openedv/development_board_ATK-DLT527B/01_codes/README.md

## Codes

You can find the codes by clicking on [here](https://mega.nz/folder/zkAyCAJb#j_hG5ZL9e9u3v6Ev81a87w).
