openedv/development_board_ATK-DLT527B/03_core_board/01_core_board_pin_definitions/T527_PINOUT_V1.00.xlsx

Sheet: Revision History
Revision History
Revision | Date | Author | Description
0.90 | 2023-11-16 | AWA1896 | Initial Release Version
0.91 | 2024-07-24 | AWA1896 | 1. Modify "PWM3" to "PWM0-3" in Sheet "2 GPIO multiplex function". 2. Update the description of PCIE0-PERSTN signal and S-TW2 signal in Sheet ""3 Signal Description".
0.92 | December 16,2024 | AWA1233 | Update the description of GMAC in Sheet "3 Signal Description".
1.00 | 2026-01-12 | AWA1233 | Release Version

Sheet: 1 Pin Characteristics
Ball#[1] | Pin Name[2] | Type[3] | Ball Reset State[4] | Pull Up/Down[5] | Default Buffer Strength[6] | I/O Power Supply[7]
SDRAM
AK33 | SA0 | O | N/A | N/A | N/A | VCC-DRAM/VCC-DRAML
AG30 | SA1 | O | N/A | N/A | N/A | VCC-DRAM/VCC-DRAML
AJ33 | SA2 | O | N/A | N/A | N/A | VCC-DRAM/VCC-DRAML
AL27 | SA3 | O | N/A | N/A | N/A | VCC-DRAM/VCC-DRAML
AH25 | SA4 | O | N/A | N/A | N/A | VCC-DRAM/VCC-DRAML
AK27 | SA5 | O | N/A | N/A | N/A | VCC-DRAM/VCC-DRAML
AN27 | SA6 | O | N/A | N/A | N/A | VCC-DRAM/VCC-DRAML
AM33 | SA7 | O | N/A | N/A | N/A | VCC-DRAM/VCC-DRAML
AL25 | SA8 | O | N/A | N/A | N/A | VCC-DRAM/VCC-DRAML
AJ31 | SA9 | O | N/A | N/A | N/A | VCC-DRAM/VCC-DRAML
AG29 | SA10 | O | N/A | N/A | N/A | VCC-DRAM/VCC-DRAML
AJ32 | SA11 | O | N/A | N/A | N/A | VCC-DRAM/VCC-DRAML
AL31 | SA12 | O | N/A | N/A | N/A | VCC-DRAM/VCC-DRAML
AK29 | SA13 | O | N/A | N/A | N/A | VCC-DRAM/VCC-DRAML
AM28 | SA14 | O | N/A | N/A | N/A | VCC-DRAM/VCC-DRAML
AN29 | SA15 | O | N/A | N/A | N/A | VCC-DRAM/VCC-DRAML
AJ27 | SA16 | O | N/A | N/A | N/A | VCC-DRAM/VCC-DRAML
AJ30 | SA17 | O | N/A | N/A | N/A | VCC-DRAM/VCC-DRAML
AL29 | SACT | O | N/A | N/A | N/A | VCC-DRAM/VCC-DRAML
AK25 | SBA0 | O | N/A | N/A | N/A | VCC-DRAM/VCC-DRAML
AJ25 | SBA1 | O | N/A | N/A | N/A | VCC-DRAM/VCC-DRAML
AN26 | SBG0 | O | N/A | N/A | N/A | VCC-DRAM/VCC-DRAML
AM27 | SBG1 | O | N/A | N/A | N/A | VCC-DRAM/VCC-DRAML
AM31 | SCKE0 | O | N/A | N/A | N/A | VCC-DRAM/VCC-DRAML
AM30 | SCKP | O | N/A | N/A | N/A | VCC-DRAM/VCC-DRAML
AN30 | SCKN | O | N/A | N/A | N/A | VCC-DRAM/VCC-DRAML
AN32 | SCS0 | O | N/A | N/A | N/A | VCC-DRAM/VCC-DRAML
AM32 | SCS1 | O | N/A | N/A | N/A | VCC-DRAM/VCC-DRAML
AE28 | SDQ0 | I/O | N/A | N/A | N/A | VCC-DRAM/VCC-DRAML
AE27 | SDQ1 | I/O | N/A | N/A | N/A | VCC-DRAM/VCC-DRAML
AG32 | SDQ2 | I/O | N/A | N/A | N/A | VCC-DRAM/VCC-DRAML
AH33 | SDQ3 | I/O | N/A | N/A | N/A | VCC-DRAM/VCC-DRAML
AE30 | SDQ4 | I/O | N/A | N/A | N/A | VCC-DRAM/VCC-DRAML
AD32 | SDQ5 | I/O | N/A | N/A | N/A | VCC-DRAM/VCC-DRAML
AE31 | SDQ6 | I/O | N/A | N/A | N/A | VCC-DRAM/VCC-DRAML
AD33 | SDQ7 | I/O | N/A | N/A | N/A | VCC-DRAM/VCC-DRAML
AC27 | SDQ8 | I/O | N/A | N/A | N/A | VCC-DRAM/VCC-DRAML
AC28 | SDQ9 | I/O | N/A | N/A | N/A | VCC-DRAM/VCC-DRAML
AC30 | SDQ10 | I/O | N/A | N/A | N/A | VCC-DRAM/VCC-DRAML
AC31 | SDQ11 | I/O | N/A | N/A | N/A | VCC-DRAM/VCC-DRAML
AA33 | SDQ12 | I/O | N/A | N/A | N/A | VCC-DRAM/VCC-DRAML
AA31 | SDQ13 | I/O | N/A | N/A | N/A | VCC-DRAM/VCC-DRAML
AA28 | SDQ14 | I/O | N/A | N/A | N/A | VCC-DRAM/VCC-DRAML
AA27 | SDQ15 | I/O | N/A | N/A | N/A | VCC-DRAM/VCC-DRAML
AM25 | SDQ16 | I/O | N/A | N/A | N/A | VCC-DRAM/VCC-DRAML
AN25 | SDQ17 | I/O | N/A | N/A | N/A | VCC-DRAM/VCC-DRAML
AH23 | SDQ18 | I/O | N/A | N/A | N/A | VCC-DRAM/VCC-DRAML
AK23 | SDQ19 | I/O | N/A | N/A | N/A | VCC-DRAM/VCC-DRAML
AL23 | SDQ20 | I/O | N/A | N/A | N/A | VCC-DRAM/VCC-DRAML
AM22 | SDQ21 | I/O | N/A | N/A | N/A | VCC-DRAM/VCC-DRAML
AN21 | SDQ22 | I/O | N/A | N/A | N/A | VCC-DRAM/VCC-DRAML
AG21 | SDQ23 | I/O | N/A | N/A | N/A | VCC-DRAM/VCC-DRAML
AG19 | SDQ24 | I/O | N/A | N/A | N/A | VCC-DRAM/VCC-DRAML
AH19 | SDQ25 | I/O | N/A | N/A | N/A | VCC-DRAM/VCC-DRAML
AK19 | SDQ26 | I/O | N/A | N/A | N/A | VCC-DRAM/VCC-DRAML
AL19 | SDQ27 | I/O | N/A | N/A | N/A | VCC-DRAM/VCC-DRAML
AM21 | SDQ28 | I/O | N/A | N/A | N/A | VCC-DRAM/VCC-DRAML
AL21 | SDQ29 | I/O | N/A | N/A | N/A | VCC-DRAM/VCC-DRAML
AK21 | SDQ30 | I/O | N/A | N/A | N/A | VCC-DRAM/VCC-DRAML
AH21 | SDQ31 | I/O | N/A | N/A | N/A | VCC-DRAM/VCC-DRAML
AE33 | SDQM0 | I/O | N/A | N/A | N/A | VCC-DRAM/VCC-DRAML
AC32 | SDQM1 | I/O | N/A | N/A | N/A | VCC-DRAM/VCC-DRAML
AM24 | SDQM2 | I/O | N/A | N/A | N/A | VCC-DRAM/VCC-DRAML
AN20 | SDQM3 | I/O | N/A | N/A | N/A | VCC-DRAM/VCC-DRAML
AF32 | SDQS0P | I/O | N/A | N/A | N/A | VCC-DRAM/VCC-DRAML
AF33 | SDQS0N | I/O | N/A | N/A | N/A | VCC-DRAM/VCC-DRAML
AB32 | SDQS1P | I/O | N/A | N/A | N/A | VCC-DRAM/VCC-DRAML
AB33 | SDQS1N | I/O | N/A | N/A | N/A | VCC-DRAM/VCC-DRAML
AM23 | SDQS2P | I/O | N/A | N/A | N/A | VCC-DRAM/VCC-DRAML
AN23 | SDQS2N | I/O | N/A | N/A | N/A | VCC-DRAM/VCC-DRAML
AM19 | SDQS3P | I/O | N/A | N/A | N/A | VCC-DRAM/VCC-DRAML
AN19 | SDQS3N | I/O | N/A | N/A | N/A | VCC-DRAM/VCC-DRAML
AL32 | SODT0 | O | N/A | N/A | N/A | VCC-DRAM/VCC-DRAML
AL33 | SODT1 | O | N/A | N/A | N/A | VCC-DRAM/VCC-DRAML
AG23 | SRST | O | N/A | N/A | N/A | VCC-DRAM/VCC-DRAML
AA29 | SZQ | AI | N/A | N/A | N/A | VCC-DRAM/VCC-DRAML
W23, W24, W25, Y24, AA24, AB24, AC24 | VCC-DRAM | P | N/A | N/A | N/A | N/A
AC17, AC18, AC19, AC20, AC22 | VCC-DRAML | P | N/A | N/A | N/A | N/A
AD25 | VDD18-DRAM | P | N/A | N/A | N/A | N/A
System
F16 | FEL | I | PU | PU | N/A | VCC-IO
G16 | JTAG-SEL | I | PU | PU | N/A | VCC-IO
AM10 | NMI | I/O, OD | N/A | N/A | N/A | VCC-RTC
AJ11 | RESET | I/O, OD | N/A | N/A | N/A | VCC-RTC
RTC&PLL
AL11 | X32KFOUT | AO, OD | N/A | N/A | N/A | VCC-PM
AM12 | X32KIN | AI | N/A | N/A | N/A | VCC-RTC
AM11 | X32KOUT | AO | N/A | N/A | N/A | VCC-RTC
AE13 | VCC-RTC | P | N/A | N/A | N/A | N/A
AG15 | VCC-PLL | P | N/A | N/A | N/A | N/A
DCXO
AM13 | DXIN | AI | N/A | N/A | N/A | VCC-DCXO
AN13 | DXOUT | AO | N/A | N/A | N/A | VCC-DCXO
AM14 | REFCLK-OUT | AO | N/A | N/A | N/A | VCC-DCXO
AK13 | WREQIN | I | N/A | N/A | N/A | VCC-PG
AD15 | VCC-DCXO | P | N/A | N/A | N/A | N/A
USB2.0 DRD
A24 | USB0-DP | A I/O | N/A | N/A | N/A | VCC33-USB
B24 | USB0-DM | A I/O | N/A | N/A | N/A | VCC33-USB
G22 | USB0-REXT | AO | N/A | N/A | N/A | VCC33-USB
K19 | VCC33-USB | P | N/A | N/A | N/A | N/A
J19 | VCC33-18-USB | P | N/A | N/A | N/A | N/A
L18 | VDD09-USB | P | N/A | N/A | N/A | N/A
USB2.0 Host
D24 | USB1-DP | A I/O | N/A | N/A | N/A | VCC33-USB
E24 | USB1-DM | A I/O | N/A | N/A | N/A | VCC33-USB
G24 | USB1-REXT | AO | N/A | N/A | N/A | VCC33-USB
PCIe2.1&USB3.1 DRD
D22 | USB2-DP | A I/O | N/A | N/A | N/A | VCC33-USB-2
E22 | USB2-DM | A I/O | N/A | N/A | N/A | VCC33-USB-2
G20 | USB2-REXT | AO | N/A | N/A | N/A | VCC33-USB-2
B21 | PCIE-REF-CLKP | A I/O | N/A | N/A | N/A | VCC18-PCIE
C21 | PCIE-REF-CLKN | A I/O | N/A | N/A | N/A | VCC18-PCIE
E20 | PCIE-REXT | AO | N/A | N/A | N/A | VCC18-PCIE
B23 | PCIE-RX0-DP/USB3-RXP | A I | N/A | N/A | N/A | VCC18-PCIE
C23 | PCIE-RX0-DN/USB3-RXN | A I | N/A | N/A | N/A | VCC18-PCIE
A22 | PCIE-TX0-DP/USB3-TXP | A O | N/A | N/A | N/A | VCC18-PCIE
B22 | PCIE-TX0-DN/USB3-TXN | A O | N/A | N/A | N/A | VCC18-PCIE
L17 | VCC33-USB-2 | P | N/A | N/A | N/A | N/A
J18 | VCC33-18-USB-2 | P | N/A | N/A | N/A | N/A
J15 | VCC18-PCIE | P | N/A | N/A | N/A | N/A
J16 | VDD09-PCIE | P | N/A | N/A | N/A | N/A
eDP1.3
C32 | EDP-AUXP | A I/O | N/A | N/A | N/A | VCC18-EDP
C33 | EDP-AUXN | A I/O | N/A | N/A | N/A | VCC18-EDP
C29 | EDP-HPD | AI | N/A | N/A | N/A | VCC18-EDP
F28 | EDP-REXT | AO | N/A | N/A | N/A | VCC18-EDP
A29 | EDP-TX0P | AO | N/A | N/A | N/A | VCC18-EDP
B29 | EDP-TX0N | AO | N/A | N/A | N/A | VCC18-EDP
A30 | EDP-TX1P | AO | N/A | N/A | N/A | VCC18-EDP
B30 | EDP-TX1N | AO | N/A | N/A | N/A | VCC18-EDP
A31 | EDP-TX2P | AO | N/A | N/A | N/A | VCC18-EDP
B31 | EDP-TX2N | AO | N/A | N/A | N/A | VCC18-EDP
B32 | EDP-TX3P | AO | N/A | N/A | N/A | VCC18-EDP
B33 | EDP-TX3N | AO | N/A | N/A | N/A | VCC18-EDP
L22 | VCC18-EDP | P | N/A | N/A | N/A | N/A
M22 | VDD09-EDP | P | N/A | N/A | N/A | N/A
HDMI
E28 | HCEC | I/O | N/A | N/A | N/A | VCC18-HDMI
D28 | HHPD | I/O | N/A | N/A | N/A | VCC18-HDMI
F26 | HREXT | O | N/A | N/A | N/A | VCC18-HDMI
D26 | HSCL | O | N/A | N/A | N/A | VCC18-HDMI
E26 | HSDA | I/O | N/A | N/A | N/A | VCC18-HDMI
B27 | HTX0P | AO | N/A | N/A | N/A | VCC18-HDMI
C27 | HTX0N | AO | N/A | N/A | N/A | VCC18-HDMI
A26 | HTX1P | AO | N/A | N/A | N/A | VCC18-HDMI
B26 | HTX1N | AO | N/A | N/A | N/A | VCC18-HDMI
B25 | HTX2P | AO | N/A | N/A | N/A | VCC18-HDMI
C25 | HTX2N | AO | N/A | N/A | N/A | VCC18-HDMI
A28 | HTXCP | AO | N/A | N/A | N/A | VCC18-HDMI
B28 | HTXCN | AO | N/A | N/A | N/A | VCC18-HDMI
M21 | VCC18-HDMI | P | N/A | N/A | N/A | N/A
L21 | VDD09-HDMI | P | N/A | N/A | N/A | N/A
Audio Codec
AD2 | MICIN1P | AI | N/A | N/A | N/A | AVCC
AD1 | MICIN1N | AI | N/A | N/A | N/A | AVCC
AE2 | MICIN2P | AI | N/A | N/A | N/A | AVCC
AE1 | MICIN2N | AI | N/A | N/A | N/A | AVCC
AF2 | MICIN3P | AI | N/A | N/A | N/A | AVCC
AF1 | MICIN3N | AI | N/A | N/A | N/A | AVCC
AG2 | LINEOUTLP | AO | N/A | N/A | N/A | AVCC
AG1 | LINEOUTLN | AO | N/A | N/A | N/A | AVCC
AH2 | LINEOUTRP | AO | N/A | N/A | N/A | AVCC
AH1 | LINEOUTRN | AO | N/A | N/A | N/A | AVCC
AM2 | HPOUTR | AO | N/A | N/A | N/A | CPVIN
AL2 | HPOUTL | AO | N/A | N/A | N/A | CPVIN
AM1 | HPOUTFB | AI | N/A | N/A | N/A | CPVIN
AJ1 | MIC-DET | AI | N/A | N/A | N/A | AVCC
AJ2 | HP-DET | AI | N/A | N/A | N/A | AVCC
AK1 | MBIAS | AO | N/A | N/A | N/A | VDD33
AL1 | HBIAS | AO | N/A | N/A | N/A | VDD33
AG5 | VRA1 | AO | N/A | N/A | N/A | AVCC
AG4 | VRA2 | AO | N/A | N/A | N/A | AVCC
AC7 | VRP | P | N/A | N/A | N/A | N/A
AJ3 | CPVDD | P | N/A | N/A | N/A | N/A
AK2 | CPVEE | P | N/A | N/A | N/A | N/A
AJ5 | CPVIN | P | N/A | N/A | N/A | N/A
AB9 | AVCC | P | N/A | N/A | N/A | N/A
AE7 | ALDO-OUT | P | N/A | N/A | N/A | N/A
AC9 | VDD33 | P | N/A | N/A | N/A | N/A
AJ4 | VEE | P | N/A | N/A | N/A | N/A
AE3 | AGND | G | N/A | N/A | N/A | N/A
GPADC
W1 | GPADC0 | AI | N/A | N/A | N/A | VCC-ADC
W2 | GPADC1 | AI | N/A | N/A | N/A | VCC-ADC
W3 | GPADC2 | AI | N/A | N/A | N/A | VCC-ADC
W4 | GPADC3 | AI | N/A | N/A | N/A | VCC-ADC
W5 | GPADC4 | AI | N/A | N/A | N/A | VCC-ADC
W6 | GPADC5 | AI | N/A | N/A | N/A | VCC-ADC
Y2 | GPADC6 | AI | N/A | N/A | N/A | VCC-ADC
Y3 | GPADC7 | AI | N/A | N/A | N/A | VCC-ADC
AA1 | GPADC8 | AI | N/A | N/A | N/A | VCC-ADC
AA2 | GPADC9 | AI | N/A | N/A | N/A | VCC-ADC
AA3 | GPADC10 | AI | N/A | N/A | N/A | VCC-ADC
AA4 | GPADC11 | AI | N/A | N/A | N/A | VCC-ADC
AA5 | GPADC12 | AI | N/A | N/A | N/A | VCC-ADC
AA6 | GPADC13 | AI | N/A | N/A | N/A | VCC-ADC
AB2 | GPADC14 | AI | N/A | N/A | N/A | VCC-ADC
AB3 | GPADC15 | AI | N/A | N/A | N/A | VCC-ADC
AC2 | GPADC16 | AI | N/A | N/A | N/A | VCC-ADC
AC3 | GPADC17 | AI | N/A | N/A | N/A | VCC-ADC
AC4 | GPADC18 | AI | N/A | N/A | N/A | VCC-ADC
AC5 | GPADC19 | AI | N/A | N/A | N/A | VCC-ADC
AC6 | GPADC20 | AI | N/A | N/A | N/A | VCC-ADC
AE4 | GPADC21 | AI | N/A | N/A | N/A | VCC-ADC
AE5 | GPADC22 | AI | N/A | N/A | N/A | VCC-ADC
AE6 | GPADC23 | AI | N/A | N/A | N/A | VCC-ADC
Y9 | VCM-ADC | A I/O | N/A | N/A | N/A | VCC-ADC
AA9 | VREFP-ADC | P | N/A | N/A | N/A | N/A
Y10 | VREFN-ADC | P | N/A | N/A | N/A | N/A
W7 | VCC-ADC | P | N/A | N/A | N/A | N/A
AA7 | GND-ADC | G | N/A | N/A | N/A | N/A
LRADC
V3 | LRADC0 | AI | N/A | N/A | N/A | VCC-ADC
V2 | LRADC1 | AI | N/A | N/A | N/A | VCC-ADC
Port B
N28 | PB0 | I/O | Z | PU/PD | 4 mA | VCC-IO
N29 | PB1 | I/O | Z | PU/PD | 4 mA | VCC-IO
M31 | PB2 | I/O | Z | PU/PD | 4 mA | VCC-IO
M32 | PB3 | I/O | Z | PU/PD | 4 mA | VCC-IO
N31 | PB4 | I/O | Z | PU/PD | 4 mA | VCC-IO
N32 | PB5 | I/O | Z | PU/PD | 4 mA | VCC-IO
N33 | PB6 | I/O | Z | PU/PD | 4 mA | VCC-IO
P31 | PB7 | I/O | Z | PU/PD | 4 mA | VCC-IO
P32 | PB8 | I/O | Z | PU/PD | 4 mA | VCC-IO
R28 | PB9 | I/O | Z | PU/PD | 4 mA | VCC-IO
R29 | PB10 | I/O | Z | PU/PD | 4 mA | VCC-IO
R30 | PB11 | I/O | Z | PU/PD | 4 mA | VCC-IO
R31 | PB12 | I/O | Z | PU/PD | 4 mA | VCC-IO
R32 | PB13 | I/O | Z | PU/PD | 4 mA | VCC-IO
R33 | PB14 | I/O | Z | PU/PD | 4 mA | VCC-IO
Port C
W28 | PC0 | I/O | Z | PU/PD | 4 mA | VCC-PC
Y31 | PC1 | I/O | Z | PU/PD | 4 mA | VCC-PC
U30 | PC2 | I/O | Z | PU/PD | 4 mA | VCC-PC
U29 | PC3 | I/O | Z | PU | 4 mA | VCC-PC
U28 | PC4 | I/O | Z | PU | 4 mA | VCC-PC
Y32 | PC5 | I/O | Z | PU/PD | 4 mA | VCC-PC
W33 | PC6 | I/O | Z | PU | 4 mA | VCC-PC
W29 | PC7 | I/O | Z | PU | 4 mA | VCC-PC
W32 | PC8 | I/O | Z | PU/PD | 4 mA | VCC-PC
W31 | PC9 | I/O | Z | PU/PD | 4 mA | VCC-PC
V32 | PC10 | I/O | Z | PU/PD | 4 mA | VCC-PC
V31 | PC11 | I/O | Z | PU/PD | 4 mA | VCC-PC
U33 | PC12 | I/O | Z | PU/PD | 4 mA | VCC-PC
U32 | PC13 | I/O | Z | PU/PD | 4 mA | VCC-PC
U31 | PC14 | I/O | Z | PU/PD | 4 mA | VCC-PC
T32 | PC15 | I/O | Z | PU/PD | 4 mA | VCC-PC
T31 | PC16 | I/O | Z | PU/PD | 4 mA | VCC-PC
U26 | VCC-PC | P | N/A | N/A | N/A | N/A
Port D
D32 | PD0 | I/O | Z | PU/PD | 4 mA | VCC-PD/VCC-LVDS0
D33 | PD1 | I/O | Z | PU/PD | 4 mA | VCC-PD/VCC-LVDS0
E30 | PD2 | I/O | Z | PU/PD | 4 mA | VCC-PD/VCC-LVDS0
E31 | PD3 | I/O | Z | PU/PD | 4 mA | VCC-PD/VCC-LVDS0
E32 | PD4 | I/O | Z | PU/PD | 4 mA | VCC-PD/VCC-LVDS0
E33 | PD5 | I/O | Z | PU/PD | 4 mA | VCC-PD/VCC-LVDS0
F32 | PD6 | I/O | Z | PU/PD | 4 mA | VCC-PD/VCC-LVDS0
F33 | PD7 | I/O | Z | PU/PD | 4 mA | VCC-PD/VCC-LVDS0
G30 | PD8 | I/O | Z | PU/PD | 4 mA | VCC-PD/VCC-LVDS0
G31 | PD9 | I/O | Z | PU/PD | 4 mA | VCC-PD/VCC-LVDS0
G32 | PD10 | I/O | Z | PU/PD | 4 mA | VCC-PD/VCC-LVDS0
G33 | PD11 | I/O | Z | PU/PD | 4 mA | VCC-PD/VCC-LVDS0
H31 | PD12 | I/O | Z | PU/PD | 4 mA | VCC-PD/VCC-LVDS0
H32 | PD13 | I/O | Z | PU/PD | 4 mA | VCC-PD/VCC-LVDS0
J29 | PD14 | I/O | Z | PU/PD | 4 mA | VCC-PD/VCC-LVDS0
J30 | PD15 | I/O | Z | PU/PD | 4 mA | VCC-PD/VCC-LVDS0
J32 | PD16 | I/O | Z | PU/PD | 4 mA | VCC-PD/VCC-LVDS0
J33 | PD17 | I/O | Z | PU/PD | 4 mA | VCC-PD/VCC-LVDS0
K31 | PD18 | I/O | Z | PU/PD | 4 mA | VCC-PD/VCC-LVDS0
K32 | PD19 | I/O | Z | PU/PD | 4 mA | VCC-PD/VCC-LVDS0
L28 | PD20 | I/O | Z | PU/PD | 4 mA | VCC-PD
L29 | PD21 | I/O | Z | PU/PD | 4 mA | VCC-PD
L31 | PD22 | I/O | Z | PU/PD | 4 mA | VCC-PD
L32 | PD23 | I/O | Z | PU/PD | 4 mA | VCC-PD
L26 | VCC-PD | P | N/A | N/A | N/A | N/A
N24 | VCC-LVDS0 | P | N/A | N/A | N/A | N/A
Port E
E6 | PE0 | I/O | Z | PU/PD | 4 mA | VCC-PE
C4 | PE1 | I/O | Z | PU/PD | 4 mA | VCC-PE
E5 | PE2 | I/O | Z | PU/PD | 4 mA | VCC-PE
E4 | PE3 | I/O | Z | PU/PD | 4 mA | VCC-PE
C3 | PE4 | I/O | Z | PU/PD | 4 mA | VCC-PE
B3 | PE5 | I/O | Z | PU/PD | 4 mA | VCC-PE
A3 | PE6 | I/O | Z | PU/PD | 4 mA | VCC-PE
A2 | PE7 | I/O | Z | PU/PD | 4 mA | VCC-PE
B2 | PE8 | I/O | Z | PU/PD | 4 mA | VCC-PE
B1 | PE9 | I/O | Z | PU/PD | 4 mA | VCC-PE
C2 | PE10 | I/O | Z | PU/PD | 4 mA | VCC-PE
J7 | PE11 | I/O | Z | PU/PD | 4 mA | VCC-PE
C1 | PE12 | I/O | Z | PU/PD | 4 mA | VCC-PE
G6 | PE13 | I/O | Z | PU/PD | 4 mA | VCC-PE
L7 | PE14 | I/O | Z | PU/PD | 4 mA | VCC-PE
N7 | PE15 | I/O | Z | PU/PD | 4 mA | VCC-PE
L9 | VCC-PE | P | N/A | N/A | N/A | N/A
Port F
B20 | PF0 | I/O | Z | PU/PD | 4 mA | VCC-IO/VCC-MCSI
A20 | PF1 | I/O | Z | PU/PD | 4 mA | VCC-IO/VCC-MCSI
C19 | PF2 | I/O | Z | PU/PD | 4 mA | VCC-IO/VCC-MCSI
B19 | PF3 | I/O | Z | PU/PD | 4 mA | VCC-IO/VCC-MCSI
B18 | PF4 | I/O | Z | PU/PD | 4 mA | VCC-IO/VCC-MCSI
A18 | PF5 | I/O | Z | PU/PD | 4 mA | VCC-IO/VCC-MCSI
D20 | PF6 | I/O | Z | PU/PD | 4 mA | VCC-IO/VCC-MCSI
Port G
R1 | PG0 | I/O | Z | PU/PD | 4 mA | VCC-PG
R2 | PG1 | I/O | Z | PU | 4 mA | VCC-PG
P3 | PG2 | I/O | Z | PU | 4 mA | VCC-PG
P2 | PG3 | I/O | Z | PU | 4 mA | VCC-PG
T3 | PG4 | I/O | Z | PU | 4 mA | VCC-PG
T2 | PG5 | I/O | Z | PU | 4 mA | VCC-PG
R6 | PG6 | I/O | Z | PU/PD | 4 mA | VCC-PG
R5 | PG7 | I/O | Z | PU/PD | 4 mA | VCC-PG
R4 | PG8 | I/O | Z | PU/PD | 4 mA | VCC-PG
U6 | PG9 | I/O | Z | PU/PD | 4 mA | VCC-PG
U5 | PG10 | I/O | Z | PU/PD | 4 mA | VCC-PG
U4 | PG11 | I/O | Z | PU/PD | 4 mA | VCC-PG
U3 | PG12 | I/O | Z | PU/PD | 4 mA | VCC-PG
U2 | PG13 | I/O | Z | PU/PD | 4 mA | VCC-PG
U1 | PG14 | I/O | Z | PU/PD | 4 mA | VCC-PG
T9 | VCC-PG | P | N/A | N/A | N/A | N/A
Port H
F18 | PH0 | I/O | Z | PU/PD | 4 mA | VCC-IO
E18 | PH1 | I/O | Z | PU/PD | 4 mA | VCC-IO
D18 | PH2 | I/O | Z | PU/PD | 4 mA | VCC-IO
C17 | PH3 | I/O | Z | PU/PD | 4 mA | VCC-IO
B17 | PH4 | I/O | Z | PU/PD | 4 mA | VCC-IO
E16 | PH5 | I/O | Z | PU/PD | 4 mA | VCC-IO
G12 | PH6 | I/O | Z | PU/PD | 4 mA | VCC-IO
F14 | PH7 | I/O | Z | PU/PD | 4 mA | VCC-IO
D16 | PH8 | I/O | Z | PU/PD | 4 mA | VCC-IO
C16 | PH9 | I/O | Z | PU/PD | 4 mA | VCC-IO
B16 | PH10 | I/O | Z | PU/PD | 4 mA | VCC-IO
A16 | PH11 | I/O | Z | PU/PD | 4 mA | VCC-IO
C15 | PH12 | I/O | Z | PU/PD | 4 mA | VCC-IO
B15 | PH13 | I/O | Z | PU/PD | 4 mA | VCC-IO
E14 | PH14 | I/O | Z | PU/PD | 4 mA | VCC-IO
D14 | PH15 | I/O | Z | PU/PD | 4 mA | VCC-IO
B14 | PH16 | I/O | Z | PU/PD | 4 mA | VCC-IO
B13 | PH17 | I/O | Z | PU/PD | 4 mA | VCC-IO
A14 | PH18 | I/O | Z | PU/PD | 4 mA | VCC-IO
C13 | PH19 | I/O | Z | PU/PD | 4 mA | VCC-IO
Port I
AH13 | PI0 | I/O | Z | PU/PD | 4 mA | VCC-PI
AG13 | PI1 | I/O | Z | PU/PD | 4 mA | VCC-PI
AL15 | PI2 | I/O | Z | PU/PD | 4 mA | VCC-PI
AN15 | PI3 | I/O | Z | PU/PD | 4 mA | VCC-PI
AM15 | PI4 | I/O | Z | PU/PD | 4 mA | VCC-PI
AJ15 | PI5 | I/O | Z | PU/PD | 4 mA | VCC-PI
AK15 | PI6 | I/O | Z | PU/PD | 4 mA | VCC-PI
AH15 | PI7 | I/O | Z | PU/PD | 4 mA | VCC-PI
AL16 | PI8 | I/O | Z | PU/PD | 4 mA | VCC-PI
AM16 | PI9 | I/O | Z | PU/PD | 4 mA | VCC-PI
AN17 | PI10 | I/O | Z | PU/PD | 4 mA | VCC-PI
AM17 | PI11 | I/O | Z | PU/PD | 4 mA | VCC-PI
AL17 | PI12 | I/O | Z | PU/PD | 4 mA | VCC-PI
AK17 | PI13 | I/O | Z | PU/PD | 4 mA | VCC-PI
AM18 | PI14 | I/O | Z | PU/PD | 4 mA | VCC-PI
AH17 | PI15 | I/O | Z | PU/PD | 4 mA | VCC-PI
AJ17 | PI16 | I/O | Z | PU/PD | 4 mA | VCC-PI
AE16 | VCC-PI | P | N/A | N/A | N/A | N/A
Port J
D1 | PJ0 | I/O | Z | PU/PD | 4 mA | VCC-PJ/VCC-LVDS1
D2 | PJ1 | I/O | Z | PU/PD | 4 mA | VCC-PJ/VCC-LVDS1
E1 | PJ2 | I/O | Z | PU/PD | 4 mA | VCC-PJ/VCC-LVDS1
E2 | PJ3 | I/O | Z | PU/PD | 4 mA | VCC-PJ/VCC-LVDS1
F1 | PJ4 | I/O | Z | PU/PD | 4 mA | VCC-PJ/VCC-LVDS1
F2 | PJ5 | I/O | Z | PU/PD | 4 mA | VCC-PJ/VCC-LVDS1
G1 | PJ6 | I/O | Z | PU/PD | 4 mA | VCC-PJ/VCC-LVDS1
G2 | PJ7 | I/O | Z | PU/PD | 4 mA | VCC-PJ/VCC-LVDS1
H2 | PJ8 | I/O | Z | PU/PD | 4 mA | VCC-PJ/VCC-LVDS1
H3 | PJ9 | I/O | Z | PU/PD | 4 mA | VCC-PJ/VCC-LVDS1
G4 | PJ10 | I/O | Z | PU/PD | 4 mA | VCC-PJ/VCC-LVDS1
G5 | PJ11 | I/O | Z | PU/PD | 4 mA | VCC-PJ/VCC-LVDS1
J4 | PJ12 | I/O | Z | PU/PD | 4 mA | VCC-PJ/VCC-LVDS1
J5 | PJ13 | I/O | Z | PU/PD | 4 mA | VCC-PJ/VCC-LVDS1
L4 | PJ14 | I/O | Z | PU/PD | 4 mA | VCC-PJ/VCC-LVDS1
L5 | PJ15 | I/O | Z | PU/PD | 4 mA | VCC-PJ/VCC-LVDS1
J1 | PJ16 | I/O | Z | PU/PD | 4 mA | VCC-PJ/VCC-LVDS1
J2 | PJ17 | I/O | Z | PU/PD | 4 mA | VCC-PJ/VCC-LVDS1
N4 | PJ18 | I/O | Z | PU/PD | 4 mA | VCC-PJ/VCC-LVDS1
N5 | PJ19 | I/O | Z | PU/PD | 4 mA | VCC-PJ/VCC-LVDS1
K3 | PJ20 | I/O | Z | PU/PD | 4 mA | VCC-PJ
K2 | PJ21 | I/O | Z | PU/PD | 4 mA | VCC-PJ
L2 | PJ22 | I/O | Z | PU/PD | 4 mA | VCC-PJ
L1 | PJ23 | I/O | Z | PU/PD | 4 mA | VCC-PJ
M3 | PJ24 | I/O | Z | PU/PD | 4 mA | VCC-PJ
M2 | PJ25 | I/O | Z | PU/PD | 4 mA | VCC-PJ
N2 | PJ26 | I/O | Z | PU/PD | 4 mA | VCC-PJ
N1 | PJ27 | I/O | Z | PU/PD | 4 mA | VCC-PJ
P9 | VCC-PJ | P | N/A | N/A | N/A | N/A
N9 | VCC-LVDS1 | P | N/A | N/A | N/A | N/A
Port K
A12 | PK0 | I/O | Z | PU/PD | 4 mA | VCC-PK/VCC-MCSI
B12 | PK1 | I/O | Z | PU/PD | 4 mA | VCC-PK/VCC-MCSI
B11 | PK2 | I/O | Z | PU/PD | 4 mA | VCC-PK/VCC-MCSI
C11 | PK3 | I/O | Z | PU/PD | 4 mA | VCC-PK/VCC-MCSI
A10 | PK4 | I/O | Z | PU/PD | 4 mA | VCC-PK/VCC-MCSI
B10 | PK5 | I/O | Z | PU/PD | 4 mA | VCC-PK/VCC-MCSI
E12 | PK6 | I/O | Z | PU/PD | 4 mA | VCC-PK/VCC-MCSI
D12 | PK7 | I/O | Z | PU/PD | 4 mA | VCC-PK/VCC-MCSI
E10 | PK8 | I/O | Z | PU/PD | 4 mA | VCC-PK/VCC-MCSI
D10 | PK9 | I/O | Z | PU/PD | 4 mA | VCC-PK/VCC-MCSI
E8 | PK10 | I/O | Z | PU/PD | 4 mA | VCC-PK/VCC-MCSI
D8 | PK11 | I/O | Z | PU/PD | 4 mA | VCC-PK/VCC-MCSI
B9 | PK12 | I/O | Z | PU/PD | 4 mA | VCC-PK/VCC-MCSI
C9 | PK13 | I/O | Z | PU/PD | 4 mA | VCC-PK/VCC-MCSI
A8 | PK14 | I/O | Z | PU/PD | 4 mA | VCC-PK/VCC-MCSI
B8 | PK15 | I/O | Z | PU/PD | 4 mA | VCC-PK/VCC-MCSI
B7 | PK16 | I/O | Z | PU/PD | 4 mA | VCC-PK/VCC-MCSI
C7 | PK17 | I/O | Z | PU/PD | 4 mA | VCC-PK/VCC-MCSI
A6 | PK18 | I/O | Z | PU/PD | 4 mA | VCC-PK/VCC-MCSI
B6 | PK19 | I/O | Z | PU/PD | 4 mA | VCC-PK/VCC-MCSI
A5 | PK20 | I/O | Z | PU/PD | 4 mA | VCC-PK/VCC-MCSI
B5 | PK21 | I/O | Z | PU/PD | 4 mA | VCC-PK/VCC-MCSI
A4 | PK22 | I/O | Z | PU/PD | 4 mA | VCC-PK/VCC-MCSI
B4 | PK23 | I/O | Z | PU/PD | 4 mA | VCC-PK/VCC-MCSI
M10 | VCC-PK | P | N/A | N/A | N/A | N/A
K13 | VCC-MCSI | P | N/A | N/A | N/A | N/A
Port L
AN6 | PL0 | I/O | Z | PU | 4 mA | VCC-PL
AN5 | PL1 | I/O | Z | PU | 4 mA | VCC-PL
AN7 | PL2 | I/O | Z | PU/PD | 4 mA | VCC-PL
AM6 | PL3 | I/O | Z | PU/PD | 4 mA | VCC-PL
AM7 | PL4 | I/O | Z | PU/PD | 4 mA | VCC-PL
AL7 | PL5 | I/O | Z | PU/PD | 4 mA | VCC-PL
AN8 | PL6 | I/O | Z | PU/PD | 4 mA | VCC-PL
AM8 | PL7 | I/O | Z | PU/PD | 4 mA | VCC-PL
AN9 | PL8 | I/O | Z | PU/PD | 4 mA | VCC-PL
AM9 | PL9 | I/O | Z | PU/PD | 4 mA | VCC-PL
AK9 | PL10 | I/O | Z | PU/PD | 4 mA | VCC-PL
AJ9 | PL11 | I/O | Z | PU/PD | 4 mA | VCC-PL
AK7 | PL12 | I/O | Z | PU/PD | 4 mA | VCC-PL
AJ7 | PL13 | I/O | Z | PU/PD | 4 mA | VCC-PL
AE11 | VCC-PL | P | N/A | N/A | N/A | N/A
Port M
AN3 | PM0 | I/O | Z | PU/PD | 4 mA | VCC-PM
AN2 | PM1 | I/O | Z | PU/PD | 4 mA | VCC-PM
AM4 | PM2 | I/O | Z | PU/PD | 4 mA | VCC-PM
AM3 | PM3 | I/O | Z | PU/PD | 4 mA | VCC-PM
AN4 | PM4 | I/O | Z | PU/PD | 4 mA | VCC-PM
AL5 | PM5 | I/O | Z | PU/PD | 4 mA | VCC-PM
AG9 | VCC-PM | P | N/A | N/A | N/A | N/A
Power
L15 | VCC-IO | P | N/A | N/A | N/A | N/A
R26 | VCC-EFUSE | P | N/A | N/A | N/A | N/A
AC15 | VDD-CPUS | P | N/A | N/A | N/A | N/A
T19, T21, T22, U18, U19, U21, U22 | VDD-CPUB | P | N/A | N/A | N/A | N/A
W19, W21, Y19, Y21 | VDD-CPUL | P | N/A | N/A | N/A | N/A
R15, R17, R18 | VDD-SYS | P | N/A | N/A | N/A | N/A
N21, P21, P22 | VDD-DE | P | N/A | N/A | N/A | N/A
N13, P13 | VDD-VE | P | N/A | N/A | N/A | N/A
T11, T13, U12, U13 | VDD-GPU | P | N/A | N/A | N/A | N/A
Y12, Y13, AA12, AA13 | VDD-DNR | P | N/A | N/A | N/A | N/A
R22 | VDD-CPUBFB | P | N/A | N/A | N/A | N/A
AA19 | VDD-CPULFB | P | N/A | N/A | N/A | N/A
P18 | VDD-SYSFB | P | N/A | N/A | N/A | N/A
AB13 | VDD-DNRFB | P | N/A | N/A | N/A | N/A
Ground
A32 | AVSS | G | N/A | N/A | N/A | N/A
A33 | AVSS | G | N/A | N/A | N/A | N/A
C22 | AVSS | G | N/A | N/A | N/A | N/A
C24 | AVSS | G | N/A | N/A | N/A | N/A
C26 | AVSS | G | N/A | N/A | N/A | N/A
C28 | AVSS | G | N/A | N/A | N/A | N/A
C30 | AVSS | G | N/A | N/A | N/A | N/A
C31 | AVSS | G | N/A | N/A | N/A | N/A
E29 | AVSS | G | N/A | N/A | N/A | N/A
F22 | AVSS | G | N/A | N/A | N/A | N/A
F24 | AVSS | G | N/A | N/A | N/A | N/A
G26 | AVSS | G | N/A | N/A | N/A | N/A
G28 | AVSS | G | N/A | N/A | N/A | N/A
H24 | AVSS | G | N/A | N/A | N/A | N/A
J17 | AVSS | G | N/A | N/A | N/A | N/A
J21 | AVSS | G | N/A | N/A | N/A | N/A
J22 | AVSS | G | N/A | N/A | N/A | N/A
J23 | AVSS | G | N/A | N/A | N/A | N/A
J26 | AVSS | G | N/A | N/A | N/A | N/A
K15 | AVSS | G | N/A | N/A | N/A | N/A
K16 | AVSS | G | N/A | N/A | N/A | N/A
K21 | AVSS | G | N/A | N/A | N/A | N/A
K22 | AVSS | G | N/A | N/A | N/A | N/A
K24 | AVSS | G | N/A | N/A | N/A | N/A
K25 | AVSS | G | N/A | N/A | N/A | N/A
L16 | AVSS | G | N/A | N/A | N/A | N/A
L19 | AVSS | G | N/A | N/A | N/A | N/A
L24 | AVSS | G | N/A | N/A | N/A | N/A
M16 | AVSS | G | N/A | N/A | N/A | N/A
M18 | AVSS | G | N/A | N/A | N/A | N/A
M19 | AVSS | G | N/A | N/A | N/A | N/A
A1 | GND | G | N/A | N/A | N/A | N/A
AA15 | GND | G | N/A | N/A | N/A | N/A
AA16 | GND | G | N/A | N/A | N/A | N/A
AA18 | GND | G | N/A | N/A | N/A | N/A
AA21 | GND | G | N/A | N/A | N/A | N/A
AA22 | GND | G | N/A | N/A | N/A | N/A
AA26 | GND | G | N/A | N/A | N/A | N/A
AA30 | GND | G | N/A | N/A | N/A | N/A
AA32 | GND | G | N/A | N/A | N/A | N/A
AB10 | GND | G | N/A | N/A | N/A | N/A
AB11 | GND | G | N/A | N/A | N/A | N/A
AB12 | GND | G | N/A | N/A | N/A | N/A
AB14 | GND | G | N/A | N/A | N/A | N/A
AB15 | GND | G | N/A | N/A | N/A | N/A
AB17 | GND | G | N/A | N/A | N/A | N/A
AC1 | GND | G | N/A | N/A | N/A | N/A
AC26 | GND | G | N/A | N/A | N/A | N/A
AC29 | GND | G | N/A | N/A | N/A | N/A
AC33 | GND | G | N/A | N/A | N/A | N/A
AD11 | GND | G | N/A | N/A | N/A | N/A
AD13 | GND | G | N/A | N/A | N/A | N/A
AD14 | GND | G | N/A | N/A | N/A | N/A
AD20 | GND | G | N/A | N/A | N/A | N/A
AD21 | GND | G | N/A | N/A | N/A | N/A
AD22 | GND | G | N/A | N/A | N/A | N/A
AD9 | GND | G | N/A | N/A | N/A | N/A
AE12 | GND | G | N/A | N/A | N/A | N/A
AE14 | GND | G | N/A | N/A | N/A | N/A
AE18 | GND | G | N/A | N/A | N/A | N/A
AE19 | GND | G | N/A | N/A | N/A | N/A
AE20 | GND | G | N/A | N/A | N/A | N/A
AE21 | GND | G | N/A | N/A | N/A | N/A
AE22 | GND | G | N/A | N/A | N/A | N/A
AE23 | GND | G | N/A | N/A | N/A | N/A
AE24 | GND | G | N/A | N/A | N/A | N/A
AE25 | GND | G | N/A | N/A | N/A | N/A
AE26 | GND | G | N/A | N/A | N/A | N/A
AE29 | GND | G | N/A | N/A | N/A | N/A
AE32 | GND | G | N/A | N/A | N/A | N/A
AE9 | GND | G | N/A | N/A | N/A | N/A
AG11 | GND | G | N/A | N/A | N/A | N/A
AG25 | GND | G | N/A | N/A | N/A | N/A
AG28 | GND | G | N/A | N/A | N/A | N/A
AG3 | GND | G | N/A | N/A | N/A | N/A
AG31 | GND | G | N/A | N/A | N/A | N/A
AG33 | GND | G | N/A | N/A | N/A | N/A
AG6 | GND | G | N/A | N/A | N/A | N/A
AG7 | GND | G | N/A | N/A | N/A | N/A
AH27 | GND | G | N/A | N/A | N/A | N/A
AH32 | GND | G | N/A | N/A | N/A | N/A
AH7 | GND | G | N/A | N/A | N/A | N/A
AH9 | GND | G | N/A | N/A | N/A | N/A
AJ13 | GND | G | N/A | N/A | N/A | N/A
AJ19 | GND | G | N/A | N/A | N/A | N/A
AJ21 | GND | G | N/A | N/A | N/A | N/A
AJ23 | GND | G | N/A | N/A | N/A | N/A
AK11 | GND | G | N/A | N/A | N/A | N/A
AK32 | GND | G | N/A | N/A | N/A | N/A
AK5 | GND | G | N/A | N/A | N/A | N/A
AL12 | GND | G | N/A | N/A | N/A | N/A
AL13 | GND | G | N/A | N/A | N/A | N/A
AL14 | GND | G | N/A | N/A | N/A | N/A
AL3 | GND | G | N/A | N/A | N/A | N/A
AL9 | GND | G | N/A | N/A | N/A | N/A
AM20 | GND | G | N/A | N/A | N/A | N/A
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
Others
AH11 | NC | N/A | N/A | N/A | N/A | N/A
AG17 | NC | N/A | N/A | N/A | N/A | N/A
F20 | NC | N/A | N/A | N/A | N/A | N/A
W9 | NC | N/A | N/A | N/A | N/A | N/A
W10 | NC | N/A | N/A | N/A | N/A | N/A
U8 | NC | N/A | N/A | N/A | N/A | N/A
U10 | NC | N/A | N/A | N/A | N/A | N/A
[1] Ball#: Package ball numbers associated with each signal. [2] Pin Name: The name of the package pin. NC means these pins are not connected. [3] Type: Denotes the signal direction I (Input), O (Output), I/O (Input/Output), OD (Open-Drain), A (Analog), AI (Analog Input), AO (Analog Output), P (Power), G (Ground), N/A (Not Applicable) [4] Ball Reset State: The state of the terminal at reset. PU: Pull Up PD: Pull Down Z: High Impedance N/A: Not Applicable [5] Pull Up/Down: Denotes the presence of an internal pull-up or pull-down resistor. Pull-up and pull-down resistors can be enabled or disabled via software. PU: Internal pullup PD: Internal pulldown PU/PD: Internal pullup and pulldown N/A: Not Applicable [6] Default Buffer Strength: Defines the default drive strength of the associated output buffer. The maximum drive strength of each GPIO is 6 mA. N/A means Not Applicable. [7] I/O Power Supply: The voltage supplies for the IO buffers of the terminal. N/A means Not Applicable.

Sheet: 2 GPIO Multiplex Function
Port Groups | Pin Name | IO Type | Function2(1) | Function3(1) | Function4(1) | Function5(1) | Function6(1) | Function14(1)
Port B | PB0 | I/O | UART2-TX | SPI2-CS0 | JTAG-MS | LCD0-D0 | PWM0-6 | PB-EINT0
 | PB1 | I/O | UART2-RX | SPI2-CLK | JTAG-CK | LCD0-D1 | PWM0-7 | PB-EINT1
 | PB2 | I/O | UART2-RTS | SPI2-MOSI | JTAG-DO | LCD0-D8 | CAN-TX0 | PB-EINT2
 | PB3 | I/O | UART2-CTS | SPI2-MISO | JTAG-DI | LCD0-D9 | CAN-RX0 | PB-EINT3
 | PB4 | I/O | TWI1-SCK | I2S0-MCLK(2) |  | PWM0-8 | HDMI-SCL | PB-EINT4
 | PB5 | I/O | TWI1-SDA | I2S0-BCLK(2) |  | PWM0-9 | HDMI-SDA | PB-EINT5
 | PB6 | I/O |  | I2S0-LRCK(2) |  | PWM0-10 | HDMI-CEC | PB-EINT6
 | PB7 | I/O | OWA-IN | I2S0-DOUT0(2) | I2S0-DIN1(2) | LCD0-D16 | PWM0-11 | PB-EINT7
 | PB8 | I/O | OWA-OUT | I2S0-DIN0(2) | I2S0-DOUT1(2) | LCD0-D17 | PWM0-0 | PB-EINT8
 | PB9 | I/O | UART0-TX | TWI0-SCK |  | I2S0-DIN2(2) | I2S0-DOUT2(2) | PB-EINT9
 | PB10 | I/O | UART0-RX | TWI0-SDA | PWM0-1 | I2S0-DIN3(2) | I2S0-DOUT3(2) | PB-EINT10
 | PB11 | I/O | TWI5-SCK | UART7-RTS | SPI1-CS0 | PWM0-2 |  | PB-EINT11
 | PB12 | I/O | TWI5-SDA | UART7-CTS | SPI1-CLK | PWM0-3 |  | PB-EINT12
 | PB13 | I/O | TWI4-SCK | UART7-TX | SPI1-MOSI | PWM0-4 |  | PB-EINT13
 | PB14 | I/O | TWI4-SDA | UART7-RX | SPI1-MISO | PWM0-5 |  | PB-EINT14
Port C | PC0 | I/O | NAND-WE | SDC2-DS |  |  |  | PC-EINT0
 | PC1 | I/O | NAND-ALE | SDC2-RST |  |  |  | PC-EINT1
 | PC2 | I/O | NAND-CLE |  | SPI0-MOSI | SPIF-MOSI |  | PC-EINT2
 | PC3 | I/O | NAND-CE1 |  | SPI0-CS0 | SPIF-CS0 |  | PC-EINT3
 | PC4 | I/O | NAND-CE0 |  | SPI0-MISO | SPIF-MISO |  | PC-EINT4
 | PC5 | I/O | NAND-RE | SDC2-CLK |  |  |  | PC-EINT5
 | PC6 | I/O | NAND-RB0 | SDC2-CMD |  |  |  | PC-EINT6
 | PC7 | I/O | NAND-RB1 |  | SPI0-CS1 | SPIF-DQS |  | PC-EINT7
 | PC8 | I/O | NAND-DQ7 | SDC2-D3 |  | SPIF-D7 |  | PC-EINT8
 | PC9 | I/O | NAND-DQ6 | SDC2-D4 |  | SPIF-D6 |  | PC-EINT9
 | PC10 | I/O | NAND-DQ5 | SDC2-D0 |  | SPIF-D5 |  | PC-EINT10
 | PC11 | I/O | NAND-DQ4 | SDC2-D5 |  | SPIF-D4 |  | PC-EINT11
 | PC12 | I/O | NAND-DQS |  | SPI0-CLK | SPIF-CLK |  | PC-EINT12
 | PC13 | I/O | NAND-DQ3 | SDC2-D1 |  |  |  | PC-EINT13
 | PC14 | I/O | NAND-DQ2 | SDC2-D6 |  |  |  | PC-EINT14
 | PC15 | I/O | NAND-DQ1 | SDC2-D2 | SPI0-WP | SPIF-WP |  | PC-EINT15
 | PC16 | I/O | NAND-DQ0 | SDC2-D7 | SPI0-HOLD | SPIF-HOLD |  | PC-EINT16
Port D | PD0 | I/O | LCD0-D2 | LVDS0-D0P | DSI0-D0P | PWM0-0 |  | PD-EINT0
 | PD1 | I/O | LCD0-D3 | LVDS0-D0N | DSI0-D0N | PWM0-1 |  | PD-EINT1
 | PD2 | I/O | LCD0-D4 | LVDS0-D1P | DSI0-D1P | PWM0-2 |  | PD-EINT2
 | PD3 | I/O | LCD0-D5 | LVDS0-D1N | DSI0-D1N | PWM0-3 |  | PD-EINT3
 | PD4 | I/O | LCD0-D6 | LVDS0-D2P | DSI0-CKP | PWM0-4 |  | PD-EINT4
 | PD5 | I/O | LCD0-D7 | LVDS0-D2N | DSI0-CKN | PWM0-5 |  | PD-EINT5
 | PD6 | I/O | LCD0-D10 | LVDS0-CKP | DSI0-D2P | PWM0-6 |  | PD-EINT6
 | PD7 | I/O | LCD0-D11 | LVDS0-CKN | DSI0-D2N | PWM0-7 |  | PD-EINT7
 | PD8 | I/O | LCD0-D12 | LVDS0-D3P | DSI0-D3P | PWM0-8 |  | PD-EINT8
 | PD9 | I/O | LCD0-D13 | LVDS0-D3N | DSI0-D3N | PWM0-9 |  | PD-EINT9
 | PD10 | I/O | LCD0-D14 | LVDS1-D0P | DSI1-D0P | PWM0-10 | SPI1-CS0/DBI-CSX | PD-EINT10
 | PD11 | I/O | LCD0-D15 | LVDS1-D0N | DSI1-D0N | PWM0-11 | SPI1-CLK/DBI-SCLK | PD-EINT11
 | PD12 | I/O | LCD0-D18 | LVDS1-D1P | DSI1-D1P | PWM0-12 | SPI1-MOSI/DBI-SDO | PD-EINT12
 | PD13 | I/O | LCD0-D19 | LVDS1-D1N | DSI1-D1N | PWM0-13 | SPI1-MISO/DBI-SDI/DBI-TE/DBI-DCX | PD-EINT13
 | PD14 | I/O | LCD0-D20 | LVDS1-D2P | DSI1-CKP | PWM0-14 | UART3-TX | PD-EINT14
 | PD15 | I/O | LCD0-D21 | LVDS1-D2N | DSI1-CKN | PWM0-15 | UART3-RX | PD-EINT15
 | PD16 | I/O | LCD0-D22 | LVDS1-CKP | DSI1-D2P | PWM1-0 | UART3-RTS | PD-EINT16
 | PD17 | I/O | LCD0-D23 | LVDS1-CKN | DSI1-D2N | PWM1-1 | UART3-CTS | PD-EINT17
 | PD18 | I/O | LCD0-CLK | LVDS1-D3P | DSI1-D3P | PWM1-2 | UART4-TX | PD-EINT18
 | PD19 | I/O | LCD0-DE | LVDS1-D3N | DSI1-D3N | PWM1-3 | UART4-RX | PD-EINT19
 | PD20 | I/O | LCD0-HSYNC | PWM0-2 | UART2-TX | UART7-RTS | UART4-RTS | PD-EINT20
 | PD21 | I/O | LCD0-VSYNC | PWM0-3 | UART2-RX | UART7-CTS | UART4-CTS | PD-EINT21
 | PD22 | I/O | PWM0-1 | SPI1-HOLD/DBI-DCX/DBI-WRX | UART2-RTS | UART7-TX | TWI0-SCK | PD-EINT22
 | PD23 | I/O | PWM0-0 | SPI1-WP/DBI-TE | UART2-CTS | UART7-RX | TWI0-SDA | PD-EINT23
Port E | PE0 | I/O | MCSI0-MCLK |  |  |  |  | PE-EINT0
 | PE1 | I/O | TWI2-SCK | UART4-TX |  |  |  | PE-EINT1
 | PE2 | I/O | TWI2-SDA | UART4-RX |  |  |  | PE-EINT2
 | PE3 | I/O | TWI3-SCK | UART4-RTS |  |  |  | PE-EINT3
 | PE4 | I/O | TWI3-SDA | UART4-CTS |  |  |  | PE-EINT4
 | PE5 | I/O | MCSI1-MCLK |  | I2S2-MCLK(3) | LEDC |  | PE-EINT5
 | PE6 | I/O |  |  | I2S2-BCLK(3) | LCD0-TRIG | NCSI-D8 | PE-EINT6
 | PE7 | I/O |  |  | I2S2-LRCK(3) | LCD1-TRIG | NCSI-D9 | PE-EINT7
 | PE8 | I/O |  |  | I2S2-DOUT0(3) | LCD2-TRIG | NCSI-D10 | PE-EINT8
 | PE9 | I/O |  |  | I2S2-DIN0(3) |  | NCSI-D11 | PE-EINT9
 | PE10 | I/O | MCSI3-MCLK | PWM0-3 |  |  | NCSI-D12 | PE-EINT10
 | PE11 | I/O | TWI1-SCK | UART5-RTS | SPI2-CS0 | UART6-TX | NCSI-D13 | PE-EINT11
 | PE12 | I/O | TWI1-SDA | UART5-CTS | SPI2-CLK | UART6-RX | NCSI-D14 | PE-EINT12
 | PE13 | I/O | TWI4-SCK | UART5-TX | SPI2-MOSI | UART6-RTS | CSI0-XVS-FSYNC | PE-EINT13
 | PE14 | I/O | TWI4-SDA | UART5-RX | SPI2-MISO | UART6-CTS | CSI1-XVS-FSYNC | PE-EINT14
 | PE15 | I/O | MCSI2-MCLK | PWM0-2 |  |  | NCSI-D15 | PE-EINT15
Port F | PF0 | I/O | SDC0-D1 | JTAG-MS |  | I2S3-DIN0 | I2S3-DOUT1 | PF-EINT0
 | PF1 | I/O | SDC0-D0 | JTAG-DI |  | I2S3-DOUT0 | I2S3-DIN1 | PF-EINT1
 | PF2 | I/O | SDC0-CLK | UART0-TX |  | I2S3-DIN2 | I2S3-DOUT2 | PF-EINT2
 | PF3 | I/O | SDC0-CMD | JTAG-DO |  | I2S3-LRCK |  | PF-EINT3
 | PF4 | I/O | SDC0-D3 | UART0-RX |  | I2S3-DIN3 | I2S3-DOUT3 | PF-EINT4
 | PF5 | I/O | SDC0-D2 | JTAG-CK |  | I2S3-BCLK |  | PF-EINT5
 | PF6 | I/O |  |  |  | I2S3-MCLK |  | PF-EINT6
Port G | PG0 | I/O | SDC1-CLK |  |  |  |  | PG-EINT0
 | PG1 | I/O | SDC1-CMD |  |  |  |  | PG-EINT1
 | PG2 | I/O | SDC1-D0 | PCIE0-PERSTN |  |  |  | PG-EINT2
 | PG3 | I/O | SDC1-D1 | PCIE0-WAKEN |  |  |  | PG-EINT3
 | PG4 | I/O | SDC1-D2 | PCIE0-CLKREQN |  |  |  | PG-EINT4
 | PG5 | I/O | SDC1-D3 |  |  |  |  | PG-EINT5
 | PG6 | I/O | UART1-TX |  |  |  |  | PG-EINT6
 | PG7 | I/O | UART1-RX |  |  |  |  | PG-EINT7
 | PG8 | I/O | UART1-RTS |  |  |  |  | PG-EINT8
 | PG9 | I/O | UART1-CTS |  |  |  |  | PG-EINT9
 | PG10 | I/O |  | I2S1-MCLK |  |  |  | PG-EINT10
 | PG11 | I/O |  | I2S1-BCLK |  |  |  | PG-EINT11
 | PG12 | I/O |  | I2S1-LRCK |  |  |  | PG-EINT12
 | PG13 | I/O |  | I2S1-DOUT0 | I2S1-DIN1 |  |  | PG-EINT13
 | PG14 | I/O |  | I2S1-DIN0 | I2S1-DOUT1 |  |  | PG-EINT14
Port H | PH0 | I/O | TWI0-SCK |  |  | RGMII0-RXD1/RMII0-RXD1 |  | PH-EINT0
 | PH1 | I/O | TWI0-SDA |  |  | RGMII0-RXD0/RMII0-RXD0 |  | PH-EINT1
 | PH2 | I/O | TWI1-SCK |  | I2S2-DIN3(3) | RGMII0-RXCTL/RMII0-CRS-DV | I2S2-DOUT3(3) | PH-EINT2
 | PH3 | I/O | TWI1-SDA | IR-TX | I2S2-DIN2(3) | RGMII0-CLKIN/RMII0-RXER | I2S2-DOUT2(3) | PH-EINT3
 | PH4 | I/O | UART3-TX | SPI1-CS0 |  | RGMII0-TXD1/RMII0-TXD1 |  | PH-EINT4
 | PH5 | I/O | UART3-RX | SPI1-CLK | LEDC | RGMII0-TXD0/RMII0-TXD0 |  | PH-EINT5
 | PH6 | I/O | UART3-RTS | SPI1-MOSI | OWA-IN | RGMII0-TXCK/RMII0-TXCK |  | PH-EINT6
 | PH7 | I/O | UART3-CTS | SPI1-MISO | OWA-OUT | RGMII0-TXCTL/RMII0-TXEN |  | PH-EINT7
 | PH8 | I/O | DMIC-CLK(4) | SPI2-CS0 | I2S2-MCLK(3) | I2S2-DIN2(3) |  | PH-EINT8
 | PH9 | I/O | DMIC-DATA0(4) | SPI2-CLK | I2S2-BCLK(3) | RGMII0-MDC |  | PH-EINT9
 | PH10 | I/O | DMIC-DATA1(4) | SPI2-MOSI | I2S2-LRCK(3) | RGMII0-MDIO |  | PH-EINT10
 | PH11 | I/O | DMIC-DATA2(4) | SPI2-MISO | I2S2-DOUT0(3) | I2S2-DIN1(3) | PCIE0-PERSTN | PH-EINT11
 | PH12 | I/O | DMIC-DATA3(4) | TWI3-SCK | I2S2-DIN0(3) | I2S2-DOUT1(3) | PCIE0-WAKEN | PH-EINT12
 | PH13 | I/O |  | TWI3-SDA | I2S3-MCLK | RGMII0-EPHY-25M |  | PH-EINT13
 | PH14 | I/O |  |  | I2S3-BCLK | RGMII0-RXD3/RMII0-NULL |  | PH-EINT14
 | PH15 | I/O |  |  | I2S3-LRCK | RGMII0-RXD2/RMII0-NULL |  | PH-EINT15
 | PH16 | I/O |  | I2S3-DOUT0 | I2S3-DIN1 | RGMII0-RXCK/RMII0-NULL | CLK-FANOUT0 | PH-EINT16
 | PH17 | I/O |  | I2S3-DOUT1 | I2S3-DIN0 | RGMII0-TXD3/RMII0-NULL |  | PH-EINT17
 | PH18 | I/O | IR-TX | I2S3-DOUT2 | I2S3-DIN2 | RGMII0-TXD2/RMII0-NULL |  | PH-EINT18
 | PH19 | I/O | IR-RX | I2S3-DOUT3 | I2S3-DIN3 | LEDC | PCIE0-CLKREQN | PH-EINT19
Port I | PI0 | I/O | TWI4-SCK | UART4-TX | PWM0-1 | I2S2-DIN3(3) | I2S2-DOUT3(3) | PI-EINT0
 | PI1 | I/O | TWI4-SDA | UART4-RX | PWM0-2 | I2S2-DIN2(3) | I2S2-DOUT2(3) | PI-EINT1
 | PI2 | I/O | UART5-TX | SPI1-CS0 | PWM0-3 | I2S2-BCLK(3) |  | PI-EINT2
 | PI3 | I/O | UART5-RX | SPI1-CLK | PWM0-4 | I2S2-LRCK(3) |  | PI-EINT3
 | PI4 | I/O | UART5-RTS | SPI1-MOSI | PWM0-5 | I2S2-DOUT0(3) | I2S2-DIN1(3) | PI-EINT4
 | PI5 | I/O | UART5-CTS | SPI1-MISO | PWM0-6 | I2S2-DIN0(3) | I2S2-DOUT1(3) | PI-EINT5
 | PI6 | I/O | UART6-TX | UART4-RTS | PWM0-7 | SPI2-CS0 |  | PI-EINT6
 | PI7 | I/O | UART6-RX | UART4-CTS | PWM0-8 | SPI2-CLK |  | PI-EINT7
 | PI8 | I/O | TWI5-SCK | IR-RX | PWM0-9 | SPI2-MOSI |  | PI-EINT8
 | PI9 | I/O | TWI5-SDA | DMIC-DATA2(4) | PWM0-10 |  |  | PI-EINT9
 | PI10 | I/O | OWA-OUT | DMIC-DATA1(4) | PWM0-11 | I2S2-MCLK(3) |  | PI-EINT10
 | PI11 | I/O | UART3-TX | DMIC-DATA0(4) | PWM0-12 |  |  | PI-EINT11
 | PI12 | I/O | UART3-RX |  | PWM0-13 | SPI2-MISO |  | PI-EINT12
 | PI13 | I/O | UART6-CTS | DMIC-DATA3(4) | PWM0-14 | I2S2-MCLK(3) |  | PI-EINT13
 | PI14 | I/O | UART6-RTS | DMIC-CLK(4) | PWM0-15 |  |  | PI-EINT14
 | PI15 | I/O | UART3-RTS | TWI2-SCK | PWM1-0 | CAN-TX0 |  | PI-EINT15
 | PI16 | I/O | UART3-CTS | TWI2-SDA | PWM1-1 | CAN-RX0 |  | PI-EINT16
Port J | PJ0 | I/O | LCD1-D0 | LVDS2-D0P |  | RGMII1-RXD1/RMII1-RXD1 |  | PJ-EINT0
 | PJ1 | I/O | LCD1-D1 | LVDS2-D0N |  | RGMII1-RXD0/RMII1-RXD0 |  | PJ-EINT1
 | PJ2 | I/O | LCD1-D2 | LVDS2-D1P |  | RGMII1-RXCTL/RMII1-CRS-DV |  | PJ-EINT2
 | PJ3 | I/O | LCD1-D3 | LVDS2-D1N |  | RGMII1-CLKIN/RMII1-RXER |  | PJ-EINT3
 | PJ4 | I/O | LCD1-D4 | LVDS2-D2P |  | RGMII1-TXD1/RMII1-TXD1 |  | PJ-EINT4
 | PJ5 | I/O | LCD1-D5 | LVDS2-D2N |  | RGMII1-TXD0/RMII1-TXD0 |  | PJ-EINT5
 | PJ6 | I/O | LCD1-D6 | LVDS2-CKP |  | RGMII1-TXCK/RMII1-TXCK |  | PJ-EINT6
 | PJ7 | I/O | LCD1-D7 | LVDS2-CKN |  | RGMII1-TXCTL/RMII1-TXEN |  | PJ-EINT7
 | PJ8 | I/O | LCD1-D8 | LVDS2-D3P |  | RGMII1-MDC |  | PJ-EINT8
 | PJ9 | I/O | LCD1-D9 | LVDS2-D3N |  | RGMII1-MDIO |  | PJ-EINT9
 | PJ10 | I/O | LCD1-D10 | LVDS3-D0P |  | RGMII1-EPHY-25M |  | PJ-EINT10
 | PJ11 | I/O | LCD1-D11 | LVDS3-D0N |  | RGMII1-RXD3/RMII1-NULL |  | PJ-EINT11
 | PJ12 | I/O | LCD1-D12 | LVDS3-D1P |  | RGMII1-RXD2/RMII1-NULL |  | PJ-EINT12
 | PJ13 | I/O | LCD1-D13 | LVDS3-D1N |  | RGMII1-RXCK/RMII1-NULL |  | PJ-EINT13
 | PJ14 | I/O | LCD1-D14 | LVDS3-D2P |  | RGMII1-TXD3/RMII1-NULL |  | PJ-EINT14
 | PJ15 | I/O | LCD1-D15 | LVDS3-D2N |  | RGMII1-TXD2/RMII1-NULL |  | PJ-EINT15
 | PJ16 | I/O | LCD1-D16 | LVDS3-CKP |  |  |  | PJ-EINT16
 | PJ17 | I/O | LCD1-D17 | LVDS3-CKN |  |  |  | PJ-EINT17
 | PJ18 | I/O | LCD1-D18 | LVDS3-D3P |  |  |  | PJ-EINT18
 | PJ19 | I/O | LCD1-D19 | LVDS3-D3N |  |  |  | PJ-EINT19
 | PJ20 | I/O | LCD1-D20 | UART2-TX | UART3-RTS | SPI0-CS0 |  | PJ-EINT20
 | PJ21 | I/O | LCD1-D21 | UART2-RX | UART3-CTS | SPI0-CLK |  | PJ-EINT21
 | PJ22 | I/O | LCD1-D22 | UART2-RTS | UART3-TX | SPI0-MOSI |  | PJ-EINT22
 | PJ23 | I/O | LCD1-D23 | UART2-CTS | UART3-RX | SPI0-MISO |  | PJ-EINT23
 | PJ24 | I/O | LCD1-CLK | TWI4-SCK | UART4-TX | SPI0-CS1 |  | PJ-EINT24
 | PJ25 | I/O | LCD1-DE | TWI4-SDA | UART4-RX | SPI0-WP |  | PJ-EINT25
 | PJ26 | I/O | LCD1-HSYNC | TWI5-SCK | UART4-RTS | SPI0-HOLD |  | PJ-EINT26
 | PJ27 | I/O | LCD1-VSYNC | TWI5-SDA | UART4-CTS |  |  | PJ-EINT27
Port K | PK0 | I/O | MCSIA-D0N |  |  |  |  | PK-EINT0
 | PK1 | I/O | MCSIA-D0P |  |  |  |  | PK-EINT1
 | PK2 | I/O | MCSIA-D1N |  |  |  |  | PK-EINT2
 | PK3 | I/O | MCSIA-D1P |  |  |  |  | PK-EINT3
 | PK4 | I/O | MCSIA-CKN | TWI2-SCK |  |  |  | PK-EINT4
 | PK5 | I/O | MCSIA-CKP | TWI2-SDA |  |  |  | PK-EINT5
 | PK6 | I/O | MCSIB-D0N |  |  |  |  | PK-EINT6
 | PK7 | I/O | MCSIB-D0P |  |  |  |  | PK-EINT7
 | PK8 | I/O | MCSIB-D1N |  |  |  |  | PK-EINT8
 | PK9 | I/O | MCSIB-D1P |  |  |  |  | PK-EINT9
 | PK10 | I/O | MCSIB-CKN | TWI3-SCK |  |  |  | PK-EINT10
 | PK11 | I/O | MCSIB-CKP | TWI3-SDA |  |  |  | PK-EINT11
 | PK12 | I/O | MCSIC-D0N | UART7-TX | TWI4-SCK | NCSI-PCLK |  | PK-EINT12
 | PK13 | I/O | MCSIC-D0P | UART7-RX | TWI4-SDA | NCSI-MCLK |  | PK-EINT13
 | PK14 | I/O | MCSIC-D1N | UART7-RTS | UART5-RTS | NCSI-HSYNC |  | PK-EINT14
 | PK15 | I/O | MCSIC-D1P | UART7-CTS | UART5-CTS | NCSI-VSYNC |  | PK-EINT15
 | PK16 | I/O | MCSIC-CKN | TWI5-SCK | UART5-TX | NCSI-D0 |  | PK-EINT16
 | PK17 | I/O | MCSIC-CKP | TWI5-SDA | UART5-RX | NCSI-D1 |  | PK-EINT17
 | PK18 | I/O | MCSID-D0N | MCSI0-MCLK | UART6-TX | NCSI-D2 |  | PK-EINT18
 | PK19 | I/O | MCSID-D0P | TWI2-SCK | UART6-RX | NCSI-D3 |  | PK-EINT19
 | PK20 | I/O | MCSID-D1N | TWI2-SDA | UART6-RTS | NCSI-D4 |  | PK-EINT20
 | PK21 | I/O | MCSID-D1P | MCSI1-MCLK | UART6-CTS | NCSI-D5 |  | PK-EINT21
 | PK22 | I/O | MCSID-CKN | TWI3-SCK | PWM0-6 | NCSI-D6 |  | PK-EINT22
 | PK23 | I/O | MCSID-CKP | TWI3-SDA | PWM0-7 | NCSI-D7 |  | PK-EINT23
Port L | PL0 | I/O | S-TWI0-SCK |  |  |  |  | PL-EINT0
 | PL1 | I/O | S-TWI0-SDA |  |  |  |  | PL-EINT1
 | PL2 | I/O | S-UART0-TX | S-UART1-TX | MCU-PWM0-0 |  |  | PL-EINT2
 | PL3 | I/O | S-UART0-RX | S-UART1-RX | MCU-PWM0-1 |  |  | PL-EINT3
 | PL4 | I/O | S-JTAG-MS | S-CAN-TX0 | MCU-PWM0-2 | S-I2S0-BCLK(2) |  | PL-EINT4
 | PL5 | I/O | S-JTAG-CK | S-CAN-RX0 | MCU-PWM0-3 | S-I2S0-LRCK(2) | S-DMIC-DATA3(4) | PL-EINT5
 | PL6 | I/O | S-JTAG-DO | MCU-PWM0-4 | S-I2S0-DIN1(2) | S-I2S0-DOUT0(2) | S-DMIC-DATA2(4) | PL-EINT6
 | PL7 | I/O | S-JTAG-DI | MCU-PWM0-5 | S-I2S0-DOUT1(2) | S-I2S0-DIN0(2) | S-DMIC-DATA1(4) | PL-EINT7
 | PL8 | I/O | S-TWI1-SCK |  | S-RJTAG-MS | S-I2S0-MCLK(2) | S-DMIC-DATA0(4) | PL-EINT8
 | PL9 | I/O | S-TWI1-SDA |  | S-RJTAG-CK | S-PWM0-1 | S-DMIC-CLK(4) | PL-EINT9
 | PL10 | I/O | S-PWM0-0 |  | S-RJTAG-DO | S-DMIC-DATA0(4) | S-SPI0-CS0 | PL-EINT10
 | PL11 | I/O | S-IR-RX |  | S-RJTAG-DI | S-DMIC-DATA1(4) | S-SPI0-CLK | PL-EINT11
 | PL12 | I/O | S-TWI2-SCK | MCU-PWM0-6 | S-UART0-TX | S-DMIC-DATA2(4) | S-SPI0-MOSI | PL-EINT12
 | PL13 | I/O | S-TWI2-SDA | MCU-PWM0-7 | S-UART0-RX | S-DMIC-DATA3(4) | S-SPI0-MISO | PL-EINT13
Port M | PM0 | I/O | S-UART0-TX | S-UART1-TX | MCU-PWM0-0 |  |  | PM-EINT0
 | PM1 | I/O | S-UART0-RX | S-UART1-RX | MCU-PWM0-1 |  |  | PM-EINT1
 | PM2 | I/O | S-TWI1-SCK | S-RJTAG-MS | MCU-PWM0-4 |  |  | PM-EINT2
 | PM3 | I/O | S-TWI1-SDA | S-RJTAG-CK | MCU-PWM0-5 |  |  | PM-EINT3
 | PM4 | I/O | MCU-PWM0-6 | S-RJTAG-DO | S-TWI2-SCK |  |  | PM-EINT4
 | PM5 | I/O | S-IR-RX | S-RJTAG-DI | S-TWI2-SDA | MCU-PWM0-7 |  | PM-EINT5
(1) For each GPIO, Function0 is input function; Function1 is output function; Function7 to Function13 are reserved. (2) I2S0 signals and S-I2S0 signals cannot be connected simultaneously. (3) If I2S2 needs to be used, please ensure that the peripheral device connected to I2S2 signals will not be used with HDMI/eDP interface simultaneously. If you have more questions, please contact Allwinner FAE. (4) DMIC signals and S-DMIC signals cannot be connected simultaneously.

Sheet: 3 Signal Description
Signal Name | Description | Type
Audio Codec
MICIN1P | Microphone Differential Positive Input 1 | AI
MICIN1N | Microphone Differential Negative Input 1 | AI
MICIN2P | Microphone Differential Positive Input 2 | AI
MICIN2N | Microphone Differential Negative Input 2 | AI
MICIN3P | Microphone Differential Positive Input 3 | AI
MICIN3N | Microphone Differential Negative Input 3 | AI
LINEOUTLP | Lineout Left Channel Positive Differential Output | AO
LINEOUTLN | Lineout Left Channel Negative Differential Output | AO
LINEOUTRP | Lineout Right Channel Positive Differential Output | AO
LINEOUTRN | Lineout Right Channel Negative Differential Output | AO
HPOUTR | Headphone Right Output | AO
HPOUTL | Headphone Left Output | AO
HPOUTFB | Pseudo Differential Headphone Ground Reference | AI
MIC-DET | Headphone MIC detect | AI
HP-DET | Headphone Jack detect | AI
MBIAS | First bias voltage output for main microphone | AO
HBIAS | Second bias voltage output for headset microphone | AO
VRA1 | Internal Reference Voltage | AO
VRA2 | Internal Reference Voltage | AO
CPVDD | Analog power for headphone charge pump | P
CPVEE | Charge pump negative voltage output | P
CPVIN | Analog power for LDO | P
AVCC | Power Supply for Analog Part | P
ALDO-OUT | Power Supply for AVCC | P
VDD33 | Power Supply for 3.3V Analog Part | P
VEE | Negative Voltage to Headphone | P
VRP | High Reference Voltage | P
AGND | Analog Ground | G
CIR_RX
IR-RX | Consumer Infrared Receiver | I
S-IR-RX | Consumer infrared receiver | I
CIR_TX
IR-TX | Consumer Infrared Transmitter | O
DCXO
DXIN | Digital Compensated Crystal Oscillator Input | AI
DXOUT | Digital Compensated Crystal Oscillator Output | AO
REFCLK-OUT | Digital Compensated Crystal Oscillator Clock Fanout | AO
WREQIN | Request signal of REFCLK_OUT | I
VCC-DCXO | Digital Compensated Crystal Oscillator Power Supply | P
DMIC
DMIC-DATA[3:0] | Digital Microphone Data Input | I
DMIC-CLK | Digital Microphone Clock Output | O
S-DMIC-DATA[3:0] | Digital Microphone Data Input | I
S-DMIC-CLK | Digital Microphone Clock Output | O
HDMI
HCEC | HDMI Consumer Electronics Control | I/O
HHPD | HDMI Hot Plug Detection Signal | I/O
HREXT | HDMI Reference Resistance | O
HSCL | HDMI Serial Clock | O
HSDA | HDMI Serial Data | I/O
HTX0P | HDMI Positive TMDS Differential Line Driver Data0 Output | AO
HTX0N | HDMI Negative TMDS Differential Line Driver Data0 Output | AO
HTX1P | HDMI Positive TMDS Differential Line Driver Data1 Output | AO
HTX1N | HDMI Negative TMDS Differential Line Driver Data1 Output | AO
HTX2P | HDMI Positive TMDS Differential Line Driver Data2 Output | AO
HTX2N | HDMI Negative TMDS Differential Line Driver Data2 Output | AO
HTXCP | HDMI Positive TMDS Differential Line Driver Clock Output | AO
HTXCN | HDMI Negative TMDS Differential Line Driver Clock Output | AO
VCC18-HDMI | 1.8V Analog Supply for IO | P
VDD09-HDMI | 0.9V HDMI Digital Power Supply | P
eDP1.3
EDP-AUXP | AUX Channel Positive Input/Output | A I/O
EDP-AUXN | AUX Channel Negative Input/Output | A I/O
EDP-HPD | Hot Plug Detection Signal | AI
EDP-REXT | eDP External Reference Resistor | AO
EDP-TX0P | eDP Positive Output of Data Channel0 | AO
EDP-TX0N | eDP Negative Output of Data Channel0 | AO
EDP-TX1P | eDP Positive Output of Data Channel1 | AO
EDP-TX1N | eDP Negative Output of Data Channel1 | AO
EDP-TX2P | eDP Positive Output of Data Channel2 | AO
EDP-TX2N | eDP Negative Output of Data Channel2 | AO
EDP-TX3P | eDP Positive Output of Data Channel3 | AO
EDP-TX3N | eDP Negative Output of Data Channel3 | AO
VCC18-EDP | 1.8V Analog Supply | P
VDD09-EDP | 0.9V Digital Supply | P
GMAC
RGMII0-RXD0/RMII0-RXD0 | RGMII/RMII Receive Data0 | I
RGMII0-RXD1/RMII0-RXD1 | RGMII/RMII Receive Data1 | I
RGMII0-RXD2/RMII0-NULL | RGMII Receive Data2 | I
RGMII0-RXD3/RMII0-NULL | RGMII Receive Data3 | I
RGMII0-RXCK/ RMII0-NULL | RGMII Receive Clock | I
RGMII0-RXCTRL/RMII0-CRS-DV | RGMII Receive Control/RMII Carrier Sense Receive Data Valid | I
RGMII0-CLKIN/RMII0-RXER | RGMII Transmit Clock from External/RMII Receive Error | I
RGMII0-TXD0/RMII0-TXD0 | RGMII/RMII Transmit Data0 | O
RGMII0-TXD1/RMII0-TXD1 | RGMII/RMII Transmit Data1 | O
RGMII0-TXD2/RMII0-NULL | RGMII Transmit Data2 | O
RGMII0-TXD3/RMII0-NULL | RGMII Transmit Data3 | O
RGMII0-TXCK/RMII0-TXCK | RGMII/RMII Transmit Clock | I/O
 | For RGMII, IO type is output;
 | For RMII, IO type is input
RGMII0-TXCTRL/RMII0-TXEN | RGMII Transmit Control/RMII Transmit Enable | O
RGMII0-MDC | RGMII Management Data Clock | O
RGMII0-MDIO | RGMII Management Data Input/ Output | I/O
RGMII0-EPHY-25M | 25 MHz Output for GMAC PHY | O
GMAC200
RGMII1-RXD0/RMII1-RXD0 | RGMII1/RMII1 Receive Data0 | I
RGMII1-RXD1/RMII1-RXD1 | RGMII1/RMII1 Receive Data1 | I
RGMII1-RXD2/RMII1-NULL | RGMII1 Receive Data2 | I
RGMII1-RXD3/RMII1-NULL | RGMII1 Receive Data3 | I
RGMII1-RXCK/ RMII1-NULL | RGMII1 Receive Clock | I
RGMII1-RXCTL/RMII1-CRS-DV | RGMII1 Receive Control/RMII1 Carrier Sense Receive Data Valid | I
RGMII1-CLKIN/RMII1-RXER | RGMII1 Transmit Clock from External/RMII1 Receive Error | I
RGMII1-TXD0/RMII1-TXD0 | RGMII1/RMII1 Transmit Data0 | O
RGMII1-TXD1/ RMII1-TXD1 | RGMII1 Transmit Data1 | O
RGMII1-TXD2/RMII1-NULL | RGMII1 Transmit Data2 | O
RGMII1-TXD3/RMII1-NULL | RGMII1 Transmit Data3 | O
RGMII1-TXCK/RMII1-TXCK | RGMII1/RMII1 Transmit Clock | I/O
 | For RGMII, IO type is output;
 | For RMII, IO type is input
RGMII1-TXCTL/RMII1-TXEN | RGMII1 Transmit Control/RMII1 Transmit Enable | O
RGMII1-MDC | RGMII1 Management Data Clock | O
RGMII1-MDIO | RGMII1 Management Data Input/ Output | I/O
RGMII1-EPHY-25M | 25 MHz Output for GMAC PHY | O
GPADC
GPADC0 | General Purpose ADC Input Channel 0/ BROM Boot Select | AI
GPADC1 | General Purpose ADC Input Channel 1 | AI
GPADC2 | General Purpose ADC Input Channel 2 | AI
GPADC3 | General Purpose ADC Input Channel 3 | AI
GPADC4 | General Purpose ADC Input Channel 4 | AI
GPADC5 | General Purpose ADC Input Channel 5 | AI
GPADC6 | General Purpose ADC Input Channel 6 | AI
GPADC7 | General Purpose ADC Input Channel 7 | AI
GPADC8 | General Purpose ADC Input Channel 8 | AI
GPADC9 | General Purpose ADC Input Channel 9 | AI
GPADC10 | General Purpose ADC Input Channel 10 | AI
GPADC11 | General Purpose ADC Input Channel 11 | AI
GPADC12 | General Purpose ADC Input Channel 12 | AI
GPADC13 | General Purpose ADC Input Channel 13 | AI
GPADC14 | General Purpose ADC Input Channel 14 | AI
GPADC15 | General Purpose ADC Input Channel 15 | AI
GPADC16 | General Purpose ADC Input Channel 16 | AI
GPADC17 | General Purpose ADC Input Channel 17 | AI
GPADC18 | General Purpose ADC Input Channel 18 | AI
GPADC19 | General Purpose ADC Input Channel 19 | AI
GPADC20 | General Purpose ADC Input Channel 20 | AI
GPADC21 | General Purpose ADC Input Channel 21 | AI
GPADC22 | General Purpose ADC Input Channel 22 | AI
GPADC23 | General Purpose ADC Input Channel 23 | AI
GND-ADC | Analog Ground | G
VCM-ADC | External Capacitor Connection | A I/O
VREFP-ADC | GPADC Reference Voltage (Positive) | P
VREFN-ADC | GPADC Reference Voltage (Negative) | P
VCC-ADC | Power Supply for GPADC | P
I2S/PCM
I2S0-DOUT[3:0] | I2S0/PCM0 Serial Data Output Channel [3:0] | O
I2S0-DIN[3:0] | I2S0/PCM0 Serial Data Input Channel [3:0] | I
I2S0-MCLK | I2S0 Master Clock | O
I2S0-LRCK | I2S0/PCM0 Sample Rate Clock/Sync | I/O
I2S0-BCLK | I2S0/PCM0 Bit Rate Clock | I/O
I2S1-DOUT[1:0] | I2S1/PCM1 Serial Data Output Channel [1:0] | O
I2S1-DIN[1:0] | I2S1/PCM1 Serial Data Input Channel [1:0] | I
I2S1-MCLK | I2S1 Master Clock | O
I2S1-LRCK | I2S1/PCM01Sample Rate Clock/Sync | I/O
I2S1-BCLK | I2S1/PCM1 Bit Rate Clock | I/O
I2S2-DOUT[3:0] | I2S2/PCM2 Serial Data Output Channel [3:0] | O
I2S2-DIN[3:0] | I2S2/PCM2 Serial Data Input Channel [3:0] | I
I2S2-MCLK | I2S2 Master Clock | O
I2S2-LRCK | I2S2/PCM2 Sample Rate Clock/Sync | I/O
I2S2-BCLK | I2S2/PCM2 Bit Rate Clock | I/O
I2S3-DOUT[3:0] | I2S3/PCM3 Serial Data Output Channel [3:0] | O
I2S3-DIN[3:0] | I2S3/PCM3 Serial Data Input Channel [3:0] | I
I2S3-MCLK | I2S3 Master Clock | O
I2S3-LRCK | I2S3/PCM3 Sample Rate Clock/Sync | I/O
I2S3-BCLK | I2S3/PCM3 Bit Rate Clock | I/O
S-I2S0-DIN[1:0] | S-I2S0/PCM0 Serial Data Input Channel [1:0] | I
S-I2S0-DOUT[1:0] | S-I2S0/PCM0 Serial Data Output Channel [1:0] | O
S-I2S0-MCLK | S-I2S0 Master Clock | O
S-I2S0-LRCK | S-I2S0/PCM0 Sample Rate Clock/Sync | I/O
S-I2S0-BCLK | S-I2S0/PCM0 Bit Rate Clock | I/O
JTAG
JTAG-MS | ARM CPU JTAG Mode Selection | I
JTAG-CK | ARM CPU JTAG Clock Signal | I
JTAG-DO | ARM CPU JTAG Data Output | O
JTAG-DI | ARM CPU JTAG Data Input | I
S-JTAG-MS | CPUS JTAG Mode Selection | I
S-JTAG-CK | CPUS JTAG Clock Signal | I
S-JTAG-DO | CPUS JTAG Data Output | O
S-JTAG-DI | CPUS JTAG Data Input | I
S-RJTAG-MS | RISC-V JTAG Mode Select | I
S-RJTAG-CK | RISC-V JTAG Clock Signal | I
S-RJTAG-DO | RISC-V JTAG Data Output | O
S-RJTAG-DI | RISC-V JTAG Data Input | I
LEDC
LEDC | Intelligent Control LED Signal Output | O
LRADC
LRADC0 | Low Rate ADC | AI
LRADC1 | Low Rate ADC | AI
MIPI CSI
MCSIA-D0P | MIPI CSI Controller A Data0 Positive Signal | AI
MCSIA-D0N | MIPI CSI Controller A Data0 Negative Signal | AI
MCSIA-D1P | MIPI CSI Controller A Data1 Positive Signal | AI
MCSIA-D1N | MIPI CSI Controller A Data1 Negative Signal | AI
MCSIA-CKP | MIPI CSI Controller A Clock Positive Signal | AI
MCSIA-CKN | MIPI CSI Controller A Clock Negative Signal | AI
MCSI0-MCLK | Master Clock for MIPI Sensor | O
MCSIB-D0P | MIPI CSI Controller B Data0 Positive Signal | AI
MCSIB-D0N | MIPI CSI Controller B Data0 Negative Signal | AI
MCSIB-D1P | MIPI CSI Controller B Data1 Positive Signal | AI
MCSIB-D1N | MIPI CSI Controller B Data1 Negative Signal | AI
MCSIB-CKP | MIPI CSI Controller B Clock Positive Signal | AI
MCSIB-CKN | MIPI CSI Controller B Clock Negative Signal | AI
MCSI1-MCLK | Master Clock for MIPI Sensor | O
MCSIC-D0P | MIPI CSI Controller C Data0 Positive Signal | AI
MCSIC-D0N | MIPI CSI Controller C Data0 Negative Signal | AI
MCSIC-D1P | MIPI CSI Controller C Data1 Positive Signal | AI
MCSIC-D1N | MIPI CSI Controller C Data1 Negative Signal | AI
MCSIC-CKP | MIPI CSI Controller C Clock Positive Signal | AI
MCSIC-CKN | MIPI CSI Controller C Clock Negative Signal | AI
MCSI2-MCLK | Master Clock for MIPI Sensor | O
MCSID-D0P | MIPI CSI Controller D Data0 Positive Signal | AI
MCSID-D0N | MIPI CSI Controller D Data0 Negative Signal | AI
MCSID-D1P | MIPI CSI Controller D Data1 Positive Signal | AI
MCSID-D1N | MIPI CSI Controller D Data1 Negative Signal | AI
MCSID-CKP | MIPI CSI Controller D Clock Positive Signal | AI
MCSID-CKN | MIPI CSI Controller D Clock Negative Signal | AI
MCSI3-MCLK | Master Clock for MIPI Sensor | O
CSI0-XVS-FSYNC | CSI Vertical SYNC/Frame SYNC | I/O
CSI1-XVS-FSYNC | CSI Vertical SYNC/Frame SYNC | I/O
MIPI DSI
DSI0-D0P | DSI0 Differential Data0 Positive Signal | I/O
DSI0-D0N | DSI0 Differential Data0 Negative Signal | I/O
DSI0-D1P | DSI0 Differential Data1 Positive Signal | O
DSI0-D1N | DSI0 Differential Data1 Negative Signal | O
DSI0-D2P | DSI0 Differential Data2 Positive Signal | O
DSI0-D2N | DSI0 Differential Data2 Negative Signal | O
DSI0-D3P | DSI0 Differential Data3 Positive Signal | O
DSI0-D3N | DSI0 Differential Data3 Negative Signal | O
DSI0-CKP | DSI0 Differential Clock Positive Signal | O
DSI0-CKN | DSI0 Differential Clock Negative Signal | O
DSI1-D0P | DSI1 Differential Data0 Positive Signal | I/O
DSI1-D0N | DSI1 Differential Data0 Negative Signal | I/O
DSI1-D1P | DSI1 Differential Data1 Positive Signal | O
DSI1-D1N | DSI1 Differential Data1 Negative Signal | O
DSI1-D2P | DSI1 Differential Data2 Positive Signal | O
DSI1-D2N | DSI1 Differential Data2 Negative Signal | O
DSI1-D3P | DSI1 Differential Data3 Positive Signal | O
DSI1-D3N | DSI1 Differential Data3 Negative Signal | O
DSI1-CKP | DSI1 Differential Clock Positive Signal | O
DSI1-CKN | DSI1 Differential Clock Negative Signal | O
RAW NAND Flash
NAND-WE | Nand Flash Write Enable | O
NAND-ALE | Nand Flash Address Latch Enable | O
NAND-CLE | Nand Flash Command latch Enable | O
NAND-CE[1:0] | Nand Flash Chip Select | O
NAND-RE | Nand Flash Read Enable | O
NAND-RB[1:0] | Nand Flash Ready/Busy Status Indicator Signal | I
NAND-DQ[7:0] | Nand Flash Data Bit | I/O
NAND-DQS | Nand Flash Data Strobe | I/O
OWA
OWA-IN | One Wire Audio Input | I
OWA-OUT | One Wire Audio Output | O
Parallel CSI
NCSI-PCLK | Parallel CSI Pixel Clock | I
NCSI-MCLK | Parallel CSI Master Clock | O
NCSI-HSYNC | Parallel CSI Horizontal Synchronous | I
NCSI-VSYNC | Parallel CSI Vertical Synchronous | I
NCSI-D[15:0] | Parallel CSI Data Bit | I
CSI0-XVS-FSYNC | CSI Vertical SYNC/Frame SYNC | I/O
CSI1-XVS-FSYNC | CSI Vertical SYNC/Frame SYNC | I/O
PCIe2.1&USB3.1 DRD
USB2-DP | USB2.0 Data Signal DP | A I/O
USB2-DM | USB2.0 Data Signal DM | A I/O
USB2-REXT | USB2.0 External Reference Resistor | AO
PCIE-REF-CLKP | PCIe2.1 Differential Signal REFCLK (Positive) | A I/O
PCIE-REF-CLKN | PCIe2.1 Differential Signal REFCLK (Negative) | A I/O
PCIE-REXT | PCIe2.1 External Reference Resistor | AO
PCIE-RX0-DP/USB3-RXP | PCIe2.1 Differential Signal of RX (Positive)/USB3.1 SuperSpeed Differential Signal of RX (Positive) | A I
PCIE-RX0-DN /USB3-RXN | PCIe2.1 Differential Signal of RX (Negative)/USB3.1 SuperSpeed Differential Signal of RX (Negative) | A I
PCIE-TX0-DP/USB3-TXP | PCIe2.1 Differential Signal of TX (Positive)/USB3.1 SuperSpeed Differential Signal of TX (Positive) | A O
PCIE-TX0-DN/USB3-TXN | PCIe2.1 Differential Signal of TX (Negative)/USB3.1 SuperSpeed Differential Signal of TX (Negative) | A O
PCIE0-PERSTN | PCIe0 Fundamental Reset | O
PCIE0-WAKEN | PCIe0 Wake Up | I
PCIE0-CLKREQN | PCIe0 Clock Request from PCIe Peripheral | I
VCC33-USB-2 | 3.3 V Power Supply for USB2.0 PHY | P
VCC33-18-USB-2 | 3.3 V/1.8 V Power Supply for USB2.0 PHY | P
VCC18-PCIE | 1.8 V Power Supply for PCIe2.1 | P
VDD09-PCIE | 0.9 V Power Supply for PCIe2.1 | P
PWM
PWM[19:0] | Pulse Width Modulation Output Channel [19:0] | I/O
S-PWM[9:0] | Pulse Width Modulation Output Channel [9:0] | I/O
RTC&PLL
X32KIN | Clock Input of 32.768 kHz Crystal | AI
X32KFOUT | 32.768 kHz clock Fanout | AO,OD
 | Provides low frequency clock for external devices
X32KOUT | Clock Output of 32.768 kHz Crystal | AO
PLLTEST | PLL Test Signal | AO, OD
VCC-RTC | RTC Power | P
VCC-PLL | Power Supply for System PLL | P
CAN
CAN-TX0 | CAN Transmitter0 | O
CAN-RX0 | CAN Receiver0 | I
S-CAN-TX0 | CAN Transmitter0 | O
S-CAN-RX0 | CAN Receiver0 | I
SDRAM
SA[17:0] | DRAM Address Signal to the Memory Device | O
SACT | DRAM Activation Command Output | O
SBA[1:0] | DRAM Bank Address Signal to the Memory Device | O
SBG[1:0] | DRAM Bank Group Address Signal to the Memory Device | O
SCKE | DRAM Clock Enable Signal to the Memory Device | O
SCKP | DRAM Active-High Clock Signal to the Memory Device | O
SCKN | DRAM Active-Low Clock Signal to the Memory Device | O
SCS[1:0] | DRAM Chip Select Signal to the Memory Device | O
SDQ[31:0] | DRAM Bidirectional Data Line to the Memory Device | I/O
SDQM[3:0] | DRAM Data Mask Signal to the Memory Device | I/O
SDQS[3:0]P | DRAM Active-High Bidirectional Data Strobes to the Memory Device | I/O
SDQS[3:0]N | DRAM Active-Low Bidirectional Data Strobes to the Memory Device | I/O
SODT[1:0] | DRAM On-Die Termination Output Signal | O
SRST | DRAM Reset Signal to the Memory Device | O
SZQ | DRAM ZQ Calibration(the signal connects to an external reference resistor which is used to calibrate DRAM input/output buffer) | AI
VCC-DRAM | Power Supply for DRAM IO | P
VCC-DRAML | Power Supply for DRAM IO | P
VDD18-DRAM | DRAM 1.8V Internal PAD Power | P
SPI&SPI_DBI
SPI0-CS[1:0] | SPI0 Chip Select Signal, Low Active | I/O
SPI0-CLK | SPI0 Clock Signal | I/O
 | Provides serial interface timing.
SPI0-MOSI | SPI0 Master Data Out, Slave Data In | I/O
SPI0-MISO | SPI0 Master Data In, Slave Data Out | I/O
SPI0-WP | SPI0 Write Protect, Low Active | I/O
 | Protects the memory area against all program or erase instructions.
 | It also can be used for serial data input and output for SPI Quad Input or Quad Output mode.
SPI0-HOLD | SPI0 Hold Signal | I/O
 | Pauses any serial communication with the device without deselecting or resetting it.
 | It also can be used for serial data input and output for SPI Quad Input or Quad Output mode.
SPI1-CS0 | SPI1 Chip Select Signal, Low Active | I/O
SPI1-CLK | SPI1 Clock Signal | I/O
 | Provides serial interface timing.
SPI1-MOSI | SPI1 Master Data Out, Slave Data In | I/O
SPI1-MISO | SPI1 Master Data In, Slave Data Out | I/O
SPI1-WP | SPI1 Write Protect, Low Active | I/O
 | Protects the memory area against all program or erase instructions.
 | It also can be used for serial data input and output for SPI Quad Input or Quad Output mode.
SPI1-HOLD | SPI1 Hold Signal | I/O
 | Pauses any serial communication with the device without deselecting or resetting it.
 | It also can be used for serial data input and output for SPI Quad Input or Quad Output mode.
SPI2-CS0 | SPI2 Chip Select Signal, Low Active | I/O
SPI2-CLK | SPI2 Clock Signal | I/O
 | Provides serial interface timing.
SPI2-MOSI | SPI2 Master Data Out, Slave Data In | I/O
SPI2-MISO | SPI2 Master Data In, Slave Data Out | I/O
S-SPI0-CS0 | S-SPI0 Chip Select Signal, Low Active | I/O
S-SPI0-CLK | S-SPI0 Clock Signal | I/O
 | Provides serial interface timing.
S-SPI0-MOSI | S-SPI0 Master Data Out, Slave Data In | I/O
S-SPI0-MISO | S-SPI0 Master Data In, Slave Data Out | I/O
DBI-CSX | Chip Select Signal, Low Active | I/O
DBI-SCLK | Serial Clock Signal | I/O
DBI-SDO | Data Output Signal | I/O
DBI-SDI | Data Input Signal | I/O
 | The data is sampled on the rising edge and the falling edge
DBI-TE | Tearing Effect Input | I/O
 | It is used to capture the external TE signal edge. The rising and falling edge is configurable.
DBI-DCX | DCX pin is the select output signal of data and command. | I/O
 | DCX = 0: register command;
 | DCX = 1: data or parameter.
DBI-WRX | When DBI operates in dual data lane format, the RGB666 format 2 can use WRX to transfer data | I/O
SPIFC
SPIF-CS 0 | SPI Peripheral Chip Select Signal, Low Active | O
SPIF-CLK | SPI Master Mode Clock Output | O
SPIF-MOSI | SPI Master Data Out, Slave Data In | I/O
SPIF-MISO | SPI Master Data In, Slave Data Out | I/O
SPIF-DQS | Data Strobe Signal | I
SPIF-D[7:4] | SPI Master Mode Data Input in octal mode. | I/O
 | In single/dual/quad mode, this port should stay low.
SPIF-WP | SPI Write Protect, Low Active | I/O
SPIF-HOLD | SPI Hold Signal | I/O
SMHC
SDC0-CMD | Command Signal for SD Card | I/O, OD
SDC0-CLK | Clock for SD Card | O
SDC0-D[3:0] | Data Input and Output for SD Card | I/O
SDC1-CMD | Command Signal for SDIO WIFI | I/O, OD
SDC1-CLK | Clock for SDIO WIFI | O
SDC1-D[3:0] | Data Input and Output for SDIO WIFI | I/O
SDC2-CMD | Command Signal for eMMC | I/O, OD
SDC2-CLK | Clock for eMMC | O
SDC2-D[8:0] | Data Input and Output for eMMC | I/O
SDC2-RST | Reset for eMMC | O
SDC2-DS | Data Strobe for eMMC | I
System
FEL | Boot Select | I
 | Jump to the Try Media Boot process when FEL is high level, or else enter into the mandatory upgrade process.
JTAG-SEL | JTAG mode select | I
 | The signal is used to select the port from which JTAG function outputs.
NMI | Non-Maskable Interrupt | I/O, OD
RESET | Reset Signal (Low Active) | I/O, OD
TCONLCD
LCD0-D[23:0] | LCD Data Input/Output | I/O
LCD0-CLK | LCD Clock | O
 | The pixel data are synchronized by this clock
LCD1-CLK | LCD Clock | O
 | The pixel data are synchronized by this clock
LCD0-VSYNC | LCD Vertical Sync | O
 | It indicates one new frame
LCD1-VSYNC | LCD Vertical Sync | O
 | It indicates one new frame
LCD0-HSYNC | LCD Horizontal Sync | O
 | It indicates one new scan line
LCD1-HSYNC | LCD Horizontal Sync | O
 | It indicates one new scan line
LCD0-DE | LCD Data Output Enable | O
LCD1-DE | LCD Data Output Enable | O
LCD1-D[23:0] | LCD Data Input/Output | I/O
LCD0-TRIG | LCD0 Sync It is input from peripherals for sync | I
LCD1-TRIG | LCD1 Sync It is input from peripherals for sync | I
LCD2-TRIG | LCD2 Sync It is input from peripherals for sync | I
LVDS0-D[3:0]N | LVDS0 Negative Port of Data Channel [3:0] | AO
LVDS0-D[3:0]P | LVDS0 Positive Port of Data Channel [3:0] | AO
LVDS0-CKN | LVDS0 Negative Port of Clock | AO
LVDS0-CKP | LVDS0 Positive Port of Clock | AO
LVDS1-D[3:0]P | LVDS1 Positive Port of Data Channel [3:0] | AO
LVDS1-D[3:0]N | LVDS1 Negative Port of Data Channel [3:0] | AO
LVDS1-CKP | LVDS1 Positive Port of Clock | AO
LVDS1-CKN | LVDS1 Negative Port of Clock | AO
LVDS2-D[3:0]P | LVDS2 Positive Port of Data Channel [3:0] | AO
LVDS2-D[3:0]N | LVDS2 Negative Port of Data Channel [3:0] | AO
LVDS2-CKP | LVDS2 Positive Port of Clock | AO
LVDS2-CKN | LVDS2 Negative Port of Clock | AO
LVDS3-D[3:0]P | LVDS3 Positive Port of Data Channel [3:0] | AO
LVDS3-D[3:0]N | LVDS3 Negative Port of Data Channel [3:0] | AO
LVDS3-CKP | LVDS3 Positive Port of Clock | AO
LVDS3-CKN | LVDS3 Negative Port of Clock | AO
TWI
TWI0-SCK | TWI0 Serial Clock Signal | I/O
TWI0-SDA | TWI0 Serial Data Signal | I/O
TWI1-SCK | TWI1 Serial Clock Signal | I/O
TWI1-SDA | TWI1 Serial Data Signal | I/O
TWI2-SCK | TWI2 Serial Clock Signal | I/O
TWI2-SDA | TWI2 Serial Data Signal | I/O
TWI3-SCK | TWI3 Serial Clock Signal | I/O
TWI3-SDA | TWI3 Serial Data Signal | I/O
TWI4-SCK | TWI4 Serial Clock Signal | I/O
TWI4-SDA | TWI4 Serial Data Signal | I/O
TWI5-SCK | TWI5 Serial Clock Signal | I/O
TWI5-SDA | TWI5 Serial Data Signal | I/O
S-TWI0-SCK | S-TWI0 Serial Clock Signal | I/O
S-TWI0-SDA | S-TWI0 Serial Data Signal | I/O
S-TWI1-SCK | S-TWI1 Serial Clock Signal | I/O
S-TWI1-SDA | S-TWI1 Serial Data Signal | I/O
S-TWI2-SCK | S-TWI2 Serial Clock Signal | I/O
S-TWI2-SDA | S-TWI2 Serial Data Signal | I/O
USB2.0 DRD
USB0-DP | USB2.0 Data Signal DP | A I/O
USB0-DM | USB2.0 Data Signal DM | A I/O
USB0-REXT | USB2.0 External Reference Resistor | AO
VCC33-USB | 3.3 V Analog Power Supply for USB2.0 DRD and USB2.0 Host | P
VCC33-18-USB | 3.3 V Analog Power Supply for USB2.0 DRD and USB2.0 Host | P
VDD09-USB | 0.9V USB Digital Power Supply | p
USB2.0 Host
USB1-DP | USB2.0 Data Signal DP | A I/O
USB1-DM | USB2.0 Data Signal DM | A I/O
USB1-REXT | USB2.0 External Reference Resistor | AO
UART
UART0-RX | UART0 Data Receiver | I
UART0-TX | UART0 Data Transmitter | O
UART1-RX | UART1 Data Receiver | I
UART1-TX | UART1 Data Transmitter | O
UART1-CTS | UART1 Data Clear to Send | I
UART1-RTS | UART1 Data Request to Send | O
UART2-RX | UART2 Data Receiver | I
UART2-TX | UART2 Data Transmitter | O
UART2-CTS | UART2 Data Clear to Send | I
UART2-RTS | UART2 Data Request to Send | O
UART3-RX | UART3 Data Receiver | I
UART3-TX | UART3 Data Transmitter | O
UART3-CTS | UART3 Data Clear to Send | I
UART3-RTS | UART3 Data Request to Send | O
UART4-RX | UART4 Data Receiver | I
UART4-TX | UART4 Data Transmitter | O
UART4-CTS | UART4 Data Clear to Send | I
UART4-RTS | UART4 Data Request to Send | O
UART5-RX | UART5 Data Receiver | I
UART5-TX | UART5 Data Transmitter | O
UART5-CTS | UART5 Data Clear to Send | I
UART5-RTS | UART5 Data Request to Send | O
UART6-RX | UART6 Data Receiver | I
UART6-TX | UART6 Data Transmitter | O
UART6-CTS | UART6 Data Clear to Send | I
UART6-RTS | UART6 Data Request to Send | O
UART7-RX | UART7 Data Receiver | I
UART7-TX | UART7 Data Transmitter | O
UART7-CTS | UART7 Data Clear to Send | I
UART7-RTS | UART7 Data Request to Send | O
S-UART0-RX | S-UART0 Data Receiver | I
S-UART0-TX | S-UART0 Data Transmitter | O
S-UART1-RX | S-UART1 Data Receiver | I
S-UART1-TX | S-UART1 Data Transmitter | O

Sheet: 4 Pin Map
FCBGA 17x17/0.3/0.5
 | 1 | 2 | 3 | 4 | 5 | 6 | 7 | 8 | 9 | 10 | 11 | 12 | 13 | 14 | 15 | 16 | 17 | 18 | 19 | 20 | 21 | 22 | 23 | 24 | 25 | 26 | 27 | 28 | 29 | 30 | 31 | 32 | 33
A | GND | PE7 | PE6 | PK22 | PK20 | PK18 |  | PK14 |  | PK4 |  | PK0 |  | PH18 |  | PH11 |  | PF5 |  | PF1 |  | PCIE-TX0-DP/USB3-TXP |  | USB0-DP |  | HTX1P |  | HTXCP | EDP-TX0P | EDP-TX1P | EDP-TX2P | AVSS | AVSS | A
B | PE9 | PE8 | PE5 | PK23 | PK21 | PK19 | PK16 | PK15 | PK12 | PK5 | PK2 | PK1 | PH17 | PH16 | PH13 | PH10 | PH4 | PF4 | PF3 | PF0 | PCIE-REF-CLKP | PCIE-TX0-DN/USB3-TXN | PCIE-RX0-DP/USB3-RXP | USB0-DM | HTX2P | HTX1N | HTX0P | HTXCN | EDP-TX0N | EDP-TX1N | EDP-TX2N | EDP-TX3P | EDP-TX3N | B
C | PE12 | PE10 | PE4 | PE1 |  | GND | PK17 | GND | PK13 | GND | PK3 | GND | PH19 | GND | PH12 | PH9 | PH3 | GND | PF2 | GND | PCIE-REF-CLKN | AVSS | PCIE-RX0-DN/USB3-RXN | AVSS | HTX2N | AVSS | HTX0N | AVSS | EDP-HPD | AVSS | AVSS | EDP-AUXP | EDP-AUXN | C
D | PJ0 | PJ1 |  |  |  | GND |  | PK11 |  | PK9 |  | PK7 |  | PH15 |  | PH8 |  | PH2 |  | PF6 |  | USB2-DP |  | USB1-DP |  | HSCL |  | HHPD |  |  |  | PD0 | PD1 | D
E | PJ2 | PJ3 | GND | PE3 | PE2 | PE0 |  | PK10 |  | PK8 |  | PK6 |  | PH14 |  | PH5 |  | PH1 |  | PCIE-REXT |  | USB2-DM |  | USB1-DM |  | HSDA |  | HCEC | AVSS | PD2 | PD3 | PD4 | PD5 | E
F | PJ4 | PJ5 |  |  |  | GND |  | GND |  | GND |  | GND |  | PH7 |  | FEL |  | PH0 |  | NC |  | AVSS |  | AVSS |  | HREXT |  | EDP-REXT |  |  |  | PD6 | PD7 | F
G | PJ6 | PJ7 | GND | PJ10 | PJ11 | PE13 |  | GND |  | GND |  | PH6 |  | GND |  | JTAG-SEL |  | GND |  | USB2-REXT |  | USB0-REXT |  | USB1-REXT |  | AVSS |  | AVSS | GND | PD8 | PD9 | PD10 | PD11 | G
H |  | PJ8 | PJ9 |  |  |  |  |  |  |  |  |  |  |  |  |  |  |  |  |  |  |  |  | AVSS |  |  |  |  |  |  | PD12 | PD13 |  | H
J | PJ16 | PJ17 | GND | PJ12 | PJ13 | GND | PE11 |  | GND | GND |  | GND | GND |  | VCC18-PCIE | VDD09-PCIE | AVSS | VCC33-18-USB-2 | VCC33-18-USB |  | AVSS | AVSS | AVSS |  |  | AVSS |  | GND | PD14 | PD15 | GND | PD16 | PD17 | J
K |  | PJ21 | PJ20 |  |  |  |  |  | GND | GND | GND | GND | VCC-MCSI |  | AVSS | AVSS |  |  | VCC33-USB |  | AVSS | AVSS |  | AVSS | AVSS | GND |  |  |  |  | PD18 | PD19 |  | K
L | PJ23 | PJ22 | GND | PJ14 | PJ15 | GND | PE14 |  | VCC-PE | GND |  | GND | GND |  | VCC-IO | AVSS | VCC33-USB-2 | VDD09-USB | AVSS |  | VDD09-HDMI | VCC18-EDP |  | AVSS |  | VCC-PD | GND | PD20 | PD21 | GND | PD22 | PD23 | GND | L
M |  | PJ25 | PJ24 |  |  |  |  |  |  | VCC-PK |  |  | GND |  |  | AVSS |  | AVSS | AVSS |  | VCC18-HDMI | VDD09-EDP |  |  |  |  |  |  |  |  | PB2 | PB3 |  | M
N | PJ27 | PJ26 | GND | PJ18 | PJ19 | GND | PE15 |  | VCC-LVDS1 | GND |  | GND | VDD-VE |  | GND |  |  | GND | GND |  | VDD-DE | GND |  | VCC-LVDS0 |  | GND | GND | PB0 | PB1 | GND | PB4 | PB5 | PB6 | N
P |  | PG3 | PG2 |  |  |  |  |  | VCC-PJ |  | GND |  | VDD-VE |  |  | GND |  | VDD-SYSFB | GND |  | VDD-DE | VDD-DE |  | GND |  |  |  |  |  |  | PB7 | PB8 |  | P
R | PG0 | PG1 | GND | PG8 | PG7 | PG6 | GND |  |  |  | GND |  | GND |  | VDD-SYS |  | VDD-SYS | VDD-SYS | GND |  |  | VDD-CPUBFB |  | GND |  | VCC-EFUSE | GND | PB9 | PB10 | PB11 | PB12 | PB13 | PB14 | R
T |  | PG5 | PG4 |  |  |  |  |  | VCC-PG |  | VDD-GPU |  | VDD-GPU |  | GND | GND |  | GND | VDD-CPUB |  | VDD-CPUB | VDD-CPUB |  | GND |  |  |  |  |  |  | PC16 | PC15 |  | T
U | PG14 | PG13 | PG12 | PG11 | PG10 | PG9 | GND | NC |  | NC |  | VDD-GPU | VDD-GPU | GND |  | GND |  | VDD-CPUB | VDD-CPUB |  | VDD-CPUB | VDD-CPUB |  |  | GND | VCC-PC | GND | PC4 | PC3 | PC2 | PC14 | PC13 | PC12 | U
V |  | LRADC1 | LRADC0 |  |  |  |  |  |  |  |  |  |  |  |  |  |  | GND | GND |  |  |  |  |  |  |  |  |  |  |  | PC11 | PC10 |  | V
W | GPADC0 | GPADC1 | GPADC2 | GPADC3 | GPADC4 | GPADC5 | VCC-ADC |  | NC | NC |  | GND | GND |  | GND | GND |  |  | VDD-CPUL |  | VDD-CPUL | GND | VCC-DRAM | VCC-DRAM | VCC-DRAM |  | GND | PC0 | PC7 | GND | PC9 | PC8 | PC6 | W
Y |  | GPADC6 | GPADC7 |  |  |  |  |  | VCM-ADC | VREFN-ADC |  | VDD-DNR | VDD-DNR |  | GND |  |  | GND | VDD-CPUL |  | VDD-CPUL | GND | GND | VCC-DRAM |  | GND |  |  |  |  | PC1 | PC5 |  | Y
AA | GPADC8 | GPADC9 | GPADC10 | GPADC11 | GPADC12 | GPADC13 | GND-ADC |  | VREFP-ADC |  |  | VDD-DNR | VDD-DNR |  | GND | GND |  | GND | VDD-CPULFB |  | GND | GND |  | VCC-DRAM |  | GND | SDQ15 | SDQ14 | SZQ | GND | SDQ13 | GND | SDQ12 | AA
AB |  | GPADC14 | GPADC15 |  |  |  |  |  | AVCC | GND | GND | GND | VDD-DNRFB | GND | GND |  | GND |  |  |  |  |  |  | VCC-DRAM |  |  |  |  |  |  |  | SDQS1P | SDQS1N | AB
AC | GND | GPADC16 | GPADC17 | GPADC18 | GPADC19 | GPADC20 | VRP |  | VDD33 |  |  |  |  |  | VDD-CPUS |  | VCC-DRAML | VCC-DRAML | VCC-DRAML | VCC-DRAML |  | VCC-DRAML |  | VCC-DRAM |  | GND | SDQ8 | SDQ9 | GND | SDQ10 | SDQ11 | SDQM1 | GND | AC
AD | MICIN1N | MICIN1P |  |  |  |  |  |  | GND |  | GND |  | GND | GND | VCC-DCXO |  |  |  |  | GND | GND | GND |  |  | VDD18-DRAM |  |  |  |  |  |  | SDQ5 | SDQ7 | AD
AE | MICIN2N | MICIN2P | AGND | GPADC21 | GPADC22 | GPADC23 | ALDO-OUT |  | GND |  | VCC-PL | GND | VCC-RTC | GND |  | VCC-PI |  | GND | GND | GND | GND | GND | GND | GND | GND | GND | SDQ1 | SDQ0 | GND | SDQ4 | SDQ6 | GND | SDQM0 | AE
AF | MICIN3N | MICIN3P |  |  |  |  |  |  |  |  |  |  |  |  |  |  |  |  |  |  |  |  |  |  |  |  |  |  |  |  |  | SDQS0P | SDQS0N | AF
AG | LINEOUTLN | LINEOUTLP | GND | VRA2 | VRA1 | GND | GND |  | VCC-PM |  | GND |  | PI1 |  | VCC-PLL |  | NC |  | SDQ24 |  | SDQ23 |  | SRST |  | GND |  |  | GND | SA10 | SA1 | GND | SDQ2 | GND | AG
AH | LINEOUTRN | LINEOUTRP |  |  |  |  | GND |  | GND |  | NC |  | PI0 |  | PI7 |  | PI15 |  | SDQ25 |  | SDQ31 |  | SDQ18 |  | SA4 |  | GND |  |  |  |  | GND | SDQ3 | AH
AJ | MIC-DET | HP-DET | CPVDD | VEE | CPVIN |  | PL13 |  | PL11 |  | RESET |  | GND |  | PI5 |  | PI16 |  | GND |  | GND |  | GND |  | SBA1 |  | SA16 |  |  | SA17 | SA9 | SA11 | SA2 | AJ
AK | MBIAS | CPVEE |  |  | GND |  | PL12 |  | PL10 |  | GND |  | WREQIN |  | PI6 |  | PI13 |  | SDQ26 |  | SDQ30 |  | SDQ19 |  | SBA0 |  | SA5 |  | SA13 |  |  | GND | SA0 | AK
AL | HBIAS | HPOUTL | GND |  | PM5 |  | PL5 |  | GND |  | X32KFOUT | GND | GND | GND | PI2 | PI8 | PI12 |  | SDQ27 |  | SDQ29 |  | SDQ20 |  | SA8 |  | SA3 |  | SACT |  | SA12 | SODT0 | SODT1 | AL
AM | HPOUTFB | HPOUTR | PM3 | PM2 | GND | PL3 | PL4 | PL7 | PL9 | NMI | X32KOUT | X32KIN | DXIN | REFCLK-OUT | PI4 | PI9 | PI11 | PI14 | SDQS3P | GND | SDQ28 | SDQ21 | SDQS2P | SDQM2 | SDQ16 | GND | SBG1 | SA14 | GND | SCKP | SCKE0 | SCS1 | SA7 | AM
AN | GND | PM1 | PM0 | PM4 | PL1 | PL0 | PL2 | PL6 | PL8 | GND | GND |  | DXOUT |  | PI3 |  | PI10 | GND | SDQS3N | SDQM3 | SDQ22 | GND | SDQS2N | GND | SDQ17 | SBG0 | SA6 | GND | SA15 | SCKN | GND | SCS0 | GND | AN
 | 1 | 2 | 3 | 4 | 5 | 6 | 7 | 8 | 9 | 10 | 11 | 12 | 13 | 14 | 15 | 16 | 17 | 18 | 19 | 20 | 21 | 22 | 23 | 24 | 25 | 26 | 27 | 28 | 29 | 30 | 31 | 32 | 33

Sheet: Declaration
Copyright©2026 Allwinner Technology Co.,Ltd. All Rights Reserved. This documentation is the original work and copyrighted property of Allwinner Technology Co.,Ltd (“Allwinner”). No part of this document may be reproduced, modify, publish or transmitted in any form or by any means without prior written consent of Allwinner. Trademarks and Permissions Allwinner and the Allwinner logo (incomplete enumeration) are trademarks of Allwinner Technology Co.,Ltd. All other trademarks, trade names, product or service names mentioned in this document are the property of their respective owners. Important Notice and Disclaimer The purchased products, services and features are stipulated by the contract made between Allwinner Technology Co.,Ltd (“Allwinner”) and the customer. All or part of the products, services and features described in this document may not be within the purchase scope or the usage scope. Please read the terms and conditions of the contract and relevant instructions carefully before using, and follow the instructions in this documentation strictly. Allwinner assumes no responsibility for the consequences of improper use (including but not limited to overvoltage, overclock, or excessive temperature). The information in this document is provided just as a reference or typical applications, and is subject to change without notice. Every effort has been made in the preparation of this document to ensure accuracy of the contents. Allwinner is not responsible for any damage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
