openedv/development_board_ATK-DLT527B/07_hardwares/01_development_board_specifications/Resource Distribution Diagram on the Back of ATK-DLT527B Development Board.pdf

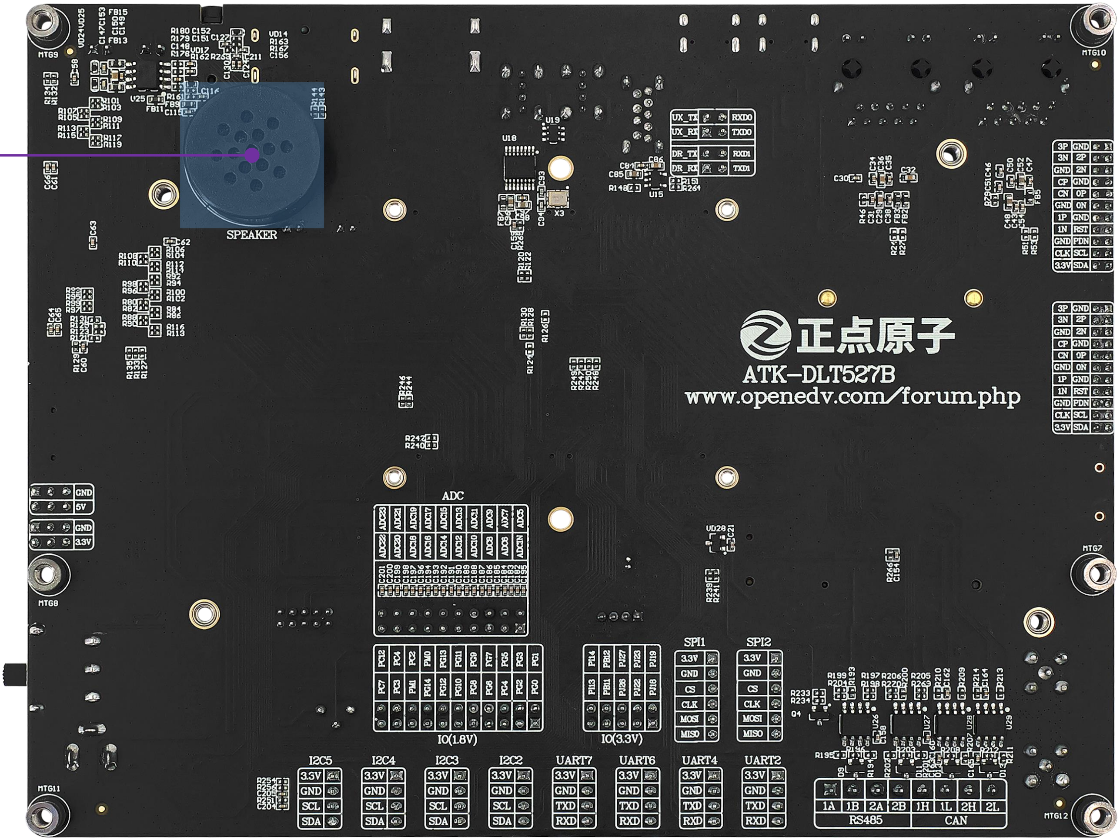
[picture p17: figure]

板载扬声器
