openedv/development_board_ATK-DLT527B/07_hardwares/06_module_materials/README.txt

Module documents can be downloaded from the document station, and will not be provided repeatedly here.
Document Station URL: http://www.openedv.com/docs/index.html
