openedv/development_board_ATK-DLT527B/08_All_winner_reference/Release_notes_release_statement/document_package_guide/AIOT_Document Package Inventory Guide.xlsx

Sheet: 版本记录
修订记录
日期 | 版本号 | 修订说明 | 修订人
2023-06-16 | 1.0 | 初始版本 | AWA1696

Sheet: AIOT产品包外发文档清单
文档包V1.0基线清单
文档包 一级目录 | 文档包 二级目录 | 文档包 三级目录 |  | 文档管理配置
名称 | 名称 | 编号 | 名称 | 格式
Release notes 发布声明 | 文档包指引 | 1 | AIOT文档包清单指引 | XLS
Hardware 硬件类文档 | 芯片手册 | 1 | Brief | PDF
 |  | 2 | Datasheet | PDF
 |  | 3 | User Manual | PDF
 |  | 4 | pinout | PDF
 | 硬件设计 | 1 | 原型机或开发板原理图 | dsn、 PDF
 |  | 2 | 硬件指标测试报告 | XLS
 |  | 3 | 原型机或开发板PCB图 | Allegro
 |  | 4 | 原型机或开发板BOM表 | PDF
 |  | 5 | 硬件DDR模板、叠层文件 | Allegro、PADS
 |  | 6 | SoC套片PCB封装库 | Allegro、PADS
 |  | 7 | 硬件设计指南 | PDF
 |  | 8 | 硬件设计checklist | XLS
 |  | 9 | 硬件设计changelist | PDF
 |  | 10 | 典型场景功耗数据 | PDF
 |  | 11 | IBIS | ibs
 |  | 12 | 原型机或开发板用户指南 | PDF
 | 硬件物料清单 | 1 | Wi-Fi_BT_支持列表 | PDF
 |  | 2 | LCD模组_支持列表 | PDF
 |  | 3 | Camera模组_支持列表 | PDF
 |  | 4 | CTP_支持列表 | PDF
 |  | 5 | DDR_支持列表 | PDF
 |  | 6 | 以太网phy_物料支持列表 | PDF
 |  | 7 | eDP屏幕_支持列表 | PDF
Software 软件类文档 | Linux模块开发指南-bsp仓库独立 | 1 | AW_安全二次开发指南 | PDF
 |  | 2 | Linux_AC101b_开发指南 | PDF
 |  | 3 | Linux_AMP_开发指南 | PDF
 |  | 4 | Linux_Audio_开发指南 | PDF
 |  | 5 | Linux_BSP独立仓库_开发指南 | PDF
 |  | 6 | Linux_CCU_开发指南 | PDF
 |  | 7 | Linux_CE_开发指南 | PDF
 |  | 8 | Linux_CedarE_开发指南 | PDF
 |  | 9 | Linux_CedarX_开发指南 | PDF
 |  | 10 | Linux_CPUFREQ_开发指南 | PDF
 |  | 11 | Linux_CPUHOTPLUG_开发指南 | PDF
 |  | 12 | Linux_CPUIDLE_开发指南 | PDF
 |  | 13 | Linux_Decoder_开发指南 | PDF
 |  | 14 | Linux_Device_Tree_使用指南 | PDF
 |  | 15 | Linux_DI_开发指南 | PDF
 |  | 16 | Linux_DMAC_开发指南 | PDF
 |  | 17 | Linux_EMAC_开发指南 | PDF
 |  | 18 | Linux_Encoder_开发指南 | PDF
 |  | 19 | Linux_GPADC_开发指南 | PDF
 |  | 20 | Linux_GPIO_开发指南 | PDF
 |  | 21 | Linux_GPU_开发指南 | PDF
 |  | 22 | Linux_HWSPINLOCK_开发指南 | PDF
 |  | 23 | Linux_I2S挂载CODEC_开发指南 | PDF
 |  | 24 | Linux_IR_RX_开发指南 | PDF
 |  | 25 | Linux_IR_TX_开发指南 | PDF
 |  | 26 | Linux_ISP_开发指南 | PDF
 |  | 27 | Linux_LEDC_开发指南 | PDF
 |  | 28 | Linux_LRADC_开发指南 | PDF
 |  | 29 | Linux_MIPI_CSI_开发指南 | PDF
 |  | 30 | Linux_MMC_开发指南 | PDF
 |  | 31 | Linux_MMC离线烧录_开发指南 | PDF
 |  | 32 | Linux_MSGBOX_开发指南 | PDF
 |  | 33 | Linux_NVP6158解码芯片_使用指南 | PDF
 |  | 34 | Linux_PCIe_开发指南 | PDF
 |  | 35 | Linux_PMIC_开发指南 | PDF
 |  | 36 | Linux_PSTORE_使用指南 | PDF
 |  | 37 | Linux_PWM_开发指南 | PDF
 |  | 38 | Linux_RTC_开发指南 | PDF
 |  | 39 | Linux_SID_开发指南 | PDF
 |  | 40 | Linux_Standby_开发指南 | PDF
 |  | 41 | Linux_Thermal_开发指南 | PDF
 |  | 42 | Linux_TIMER_开发指南 | PDF
 |  | 43 | Linux_TP2815解码芯片_使用指南 | PDF
 |  | 44 | Linux_TPADC_开发指南 | PDF
 |  | 45 | Linux_TWI_开发指南 | PDF
 |  | 46 | Linux_Type-C_开发指南 | PDF
 |  | 47 | Linux_UART_开发指南 | PDF
 |  | 48 | Linux_U-Boot_开发指南 | PDF
 |  | 49 | Linux_UFS_开发指南 | PDF
 |  | 50 | Linux_USB2_开发指南 | PDF
 |  | 51 | Linux_USB3_开发指南 | PDF
 |  | 52 | Linux_安全_开发指南 | PDF
 |  | 53 | Linux_快充_开发指南 | PDF
 |  | 54 | Linux_外部RTC_开发指南 | PDF
 |  | 55 | Linux_展频_配置指南 | PDF
 |  | 56 | Longan_Linux_开发指南 | PDF
 |  | 57 | Longan_U-Boot_开发指南 | PDF
 |  | 58 | 音效调优_开发指南 | PDF
 |  | 59 | Linux_DDR_DVFS_开发指南 | PDF
 | Linux模块差异化开发指南 | 1 | Linux_并口-CSI_开发指南 | PDF
 | 软件方案应用规范 | 1 | Android系统软件方案应用规范 | PDF
 | 显示模块开发指南 | 1 | AW_G2D_开发指南 | PDF
 | 显示模块开发指南（DRM） | 1 | AW_Developer_Guide_Linux_Graphics_CN | PDF
 |  | 2 | AW_DRM_使用指南 | PDF
 |  | 3 | AW_DRM屏幕适配_调试指南 | PDF
 |  | 4 | AW_User_Guide_Linux_DRM_CN | PDF
 |  | 5 | Linux_eDP_out_DRM_开发指南 | PDF
 |  | 6 | Linux_HDMI20_DRM_开发指南 | PDF
 | 测试报告 | 1 | [产品型号]_Ethernet_Benchmark_CN | PDF
 |  | 2 | [产品型号]_Multimedia_Codec_Benchmark | PDF
 |  | 3 | [产品型号]_PCIE_Benchmark_CN | PDF
 | NPU模块开发指南 | 1 | [产品型号]_AI_SDK产品包_使用指南 | PDF
 |  | 2 | [产品型号]_NPU_常见网络性能_测试报告 | PDF
 | NPU模块差异化开发指南 | 1 | NPU_Docker镜像开发环境_使用指南 | PDF
 |  | 2 | NPU_RuntimeAPI_参考指南 | PDF
 |  | 3 | NPU_开发环境部署_参考指南 | PDF
 |  | 4 | NPU_快速入门_开发指南 | PDF
 |  | 5 | NPU_模型部署_开发指南 | PDF
 |  | 6 | NPU_算子支持列表 | PDF
 | RTOS模块差异化开发指 | 1 | RTOS_异构快启_开发指南 | PDF
 | FreeRTOS系统基础组件开发指南 | 1 | FreeRTOS_RTOS_内存优化_使用指南 | PDF
 |  | 2 | FreeRTOS_RTOS_配置_开发指南 | PDF
 |  | 3 | FreeRTOS_RTOS_系统_开发指南 | PDF
 |  | 4 | FreeRTOS_RTOS_系统调试_使用指南 | PDF
 | Android_[版本]_基础组件 开发指南 | 1 | Android_[版本]_Camera模块_开发指南 | PDF
 |  | 2 | Android_[版本]_Lager_开发指南 | PDF
 |  | 3 | Android_[版本]_OTA_开发指南 | PDF
 |  | 4 | Android_[版本]_rotation配置_使用指南 | PDF
 |  | 5 | Android_[版本]_SDK_移植指南 | PDF
 |  | 6 | Android_[版本]_SDK基础架构_说明书 | PDF
 |  | 7 | Android_[版本]_sys_partition.fex_使用指南 | PDF
 |  | 8 | Android_[版本]_SystemUI_重要改变指南 | PDF
 |  | 9 | Android_[版本]_Wi-Fi_BT_开发指南 | PDF
 |  | 10 | Android_[版本]_方案定制规范_开发指南 | PDF
 |  | 11 | Android_[版本]_开发指南 | PDF
 |  | 12 | Android_[版本]_开源软件协议使用声明及CopyrightNotice | PDF
 |  | 13 | Android_[版本]_日志_使用指南 | PDF
 |  | 14 | Android_[版本]_应用预装_开发指南 | PDF
 |  | 15 | Android_Camera模组_选型指南 | PDF
 |  | 16 | Android_Camera自动检测_使用指南 | PDF
 |  | 19 | Android_Display_使用指南 | PDF
 |  | 25 | Android_Input_Sensor_开发指南 | PDF
 |  | 27 | Android_Input_开发指南 | PDF
 |  | 28 | Android_Miracast_开发指南 | PDF
 |  | 32 | Android_PowerHal_场景管理_开发指南 | PDF
 |  | 33 | Android_SElinux_开发指南 | PDF
 |  | 34 | Android_sys_config.fex_使用指南 | xls
 |  | 35 | Android_Widevine_开发指南 | PDF
 |  | 37 | Android_安全方案_开发指南 | PDF
 |  | 38 | Android_定制开关机动画及视频_开发指南 | PDF
 |  | 39 | Android_多媒体_开发指南 | PDF
 | Android_[版本]_差异化开发指南 | 1 | [产品型号]_Andriod_[版本]_HDMI转CSI_驱动开发指南 | PDF
 |  | 2 | AIOT_Android_[版本]_SDK版本发布_说明书 | PDF
 |  | 3 | [产品型号]_Android_[版本]_DP_IN方案_开发指南 | PDF
 |  | 4 | [产品型号]_Android_[版本]_多屏方案_开发指南 | PDF
 |  | 5 | [产品型号]_Android_[版本]_双触摸方案_开发指南 | PDF
 |  | 6 | [产品型号]_Android_[版本]_性能体验边界数据报告 | PDF
 |  | 7 | [产品型号]_Android_awCamera_API_使用指南 | PDF
 |  | 8 | [产品型号]_Android_音频_开发指南 | PDF
Tool 工具类文档 | 烧写工具 使用指南 | 1 | PhoenixSuit_使用指南 | PDF
 |  | 2 | PhoenixUSBPro_使用指南 | PDF
 |  | 3 | PhoenixUSBPro二次开发_使用指南 | PDF
 |  | 4 | PhoenixCard_使用指南 | PDF
 |  | 5 | TigerDOS远程调试工具_调试指南 | PDF
 |  | 6 | linux系统烧录工具_使用指南 | PDF
 |  | 7 | Mac电脑烧录工具_使用指南 | PDF
 |  | 8 | 全志工具包介绍 | PDF
 |  | 9 | 全志量产工具中心_使用指南 | PDF
 | 调试工具 使用指南 | 1 | DragonAtt_使用指南 | PDF
 |  | 2 | DragonBoard_使用指南 | PDF
 |  | 3 | TigerLCD调试工具_使用指南 | PDF
 |  | 4 | Crashdump调试工具_使用指南 | PDF
 |  | 5 | TigerAACT_使用指南 | PDF
 |  | 6 | DragonFace_使用指南 | PDF
 |  | 7 | DragonSN_使用指南 | PDF
 |  | 8 | TigerDump_使用指南 | PDF
Product 量产指导文档 | 产线指南 | 1 | 产线生产流程指南 | PDF
 |  | 2 | 产线批量烧写工具部署培训指南 | PDF、AVI
 |  | 3 | 产线量产稳定性检查checklist | PDF
 |  | 4 | 产线软硬件问题快速排查指南 | PDF
 |  | 5 | 产线及售后不良问题分析表及处理流程 | PDF
 |  | 6 | 全志平台生产指南之ESD基础及其防护 | PDF
 | 排查指南 | 1 | Android_Wi-Fi_BT量产问题_排查指南 | PDF
 |  | 2 | Android 低内存设备内存_优化指南 | PDF
 |  | 3 | Android 启动_优化指南 | PDF
 |  | 4 | Android_OTA升级量产问题_排查指南 | PDF
 |  | 5 | Android_Recovery量产问题_排查指南 | PDF
 |  | 6 | Android_TP量产问题_排查指南 | PDF
 |  | 7 | Android_eMMC物料_验证指南 | PDF
 |  | 8 | Android_系统调试_排查指南 | PDF
 |  | 9 | Android_Camera量产问题_排查指南 | PDF
 |  | 10 | eMMC硬件_排查指南 | PDF
 |  | 11 | Linux_eMMC物料_调试指南 | PDF
 |  | 12 | Linux_UFS物料_验证指南 | PDF
 |  | 13 | eMMC量产问题_排查指南 | PDF
 |  | 14 | IO类量产问题_排查指南 | PDF
 |  | 15 | 安全类量产问题_排查指南 | PDF
 |  | 16 | 启动烧写类量产问题_排查指南 | PDF
 |  | 17 | 量产系统稳定性问题_排查指南 | PDF
 |  | 18 | 显示类量产问题_排查指南 | PDF
 |  | 19 | 量产问题信息收集_参考模板 | PDF
 |  | 20 | 接口类量产问题_排查指南 | PDF
 |  | 21 | 显示问题案例FAE详细指导指南 | PDF
