openedv/development_board_ATK-DLT527B/08_All_winner_reference/Release_notes_release_statement/document_package_guide/T527_Linux_AIOT_Document_Package_Inventory_Guide.xlsx

AW1890_T527 linux方案产品包外发文档清单
文档包 一级目录 | 文档包 二级目录 | 文档包 三级目录 |  | 文档管理配置
名称 | 名称 | 编号 | 名称 | 格式
Release notes 发布声明 | 文档包指引 | 1 | 文档包清单指引 | XLS
 |  | 2 | 文档包版本发布声明 | PDF
Hardware 硬件类文档 | 芯片手册 | 1 | Brief | PDF
 |  | 2 | Datasheet | PDF
 |  | 3 | User Manual | PDF
 |  | 4 | PINOUT | XLS
 |  | 5 | 芯片可靠性报告 | PDF
 | 硬件设计 | 1 | 标案原理图 | dsn、 PDF
 |  | 2 | 原型机或开发板原理图 | dsn、 PDF
 |  | 3 | 原型机或开发板PCB图 | Allegro
 |  | 4 | 原型机或开发板BOM表 | PDF
 |  | 5 | 硬件DDR模板、叠层文件 | Allegro、PADS
 |  | 6 | SoC套片PCB封装库 | Allegro、PADS
 |  | 7 | 硬件设计指南 | PDF
 |  | 8 | 硬件设计checklist | XLS
 |  | 9 | 硬件设计changelist | XLS
 |  | 10 | DDR Layout指南 | PDF
 |  | 11 | IBIS | ibs
 |  | 12 | 原型机或开发板用户指南 | PDF
 |  | 14 | 硬件指标测试报告 | PDF
 | 硬件物料清单 | 1 | DDR_支持列表 | PDF
 |  | 2 | NAND_支持列表 | PDF
 |  | 3 | eMMC_支持列表 | PDF
 |  | 4 | Wi-Fi_BT_支持列表 | PDF
 |  | 5 | Camera模组_支持列表 | PDF
 | Linux模块 开发指南（适用于Linux-5.10以前的内核版本） or Linux模块开发指南-bsp仓库独立（适用于Linux-5.10及以后内核） | 1 | Longan_U-Boot_开发指南 | PDF
 |  | 2 | Linux_CCU_开发指南 | PDF
 |  | 3 | Linux_GPIO_开发指南 | PDF
 |  | 4 | Linux_DMAC_开发指南 | PDF
 |  | 5 | Linux_SPI_NG_开发指南 | PDF
 |  | 6 | Linux_TWI_开发指南 | PDF
 |  | 7 | Linux_UART_开发指南 | PDF
 |  | 8 | Linux_Standby_开发指南 | PDF
 |  | 9 | Linux_LRADC_开发指南 | PDF
 |  | 10 | Linux_GPADC_开发指南 | PDF
 |  | 11 | Linux_IR_RX_开发指南 | PDF
 |  | 12 | Linux_IR_TX_开发指南 | PDF
 |  | 13 | Linux_USB2_开发指南 | PDF
 |  | 14 | Linux_USB3_开发指南 | PDF
 |  | 15 | Linux_G2D_开发指南 | PDF
 |  | 16 | Linux_GPU_开发指南 | PDF
 |  | 17 | Linux_SID_开发指南 | PDF
 |  | 18 | Linux_MIPI-CSI_开发指南 | PDF
 |  | 19 | Linux_MMC离线烧录_开发指南 | PDF
 |  | 20 | Linux_SLC_NAND_UBI离线烧录_开发指南 | PDF
 |  | 21 | Linux_SPI_NAND_UBI离线烧录_开发指南 | PDF
 |  | 22 | Linux_MMC_开发指南 | PDF
 |  | 23 | Linux_安全_开发指南 | PDF
 |  | 24 | Linux_PMIC_开发指南 | PDF
 |  | 25 | Linux_Nand_开发指南 | PDF
 |  | 26 | Linux_NPU_开发指南 | PDF
 |  | 27 | Linux_ISP_开发指南 | PDF
 |  | 28 | Linux_RTC_开发指南 | PDF
 |  | 29 | Linux_CE_开发指南 | PDF
 |  | 30 | Linux_Device_Tree_开发指南 | PDF
 |  | 31 | Linux_Encoder_开发指南 | PDF
 |  | 32 | Linux_Decoder_开发指南 | PDF
 |  | 33 | Linux_PWM_开发指南 | PDF
 |  | 34 | Linux_SPL-PUB_开发指南 | PDF
 |  | 35 | Linux_Thermal_开发指南 | PDF
 |  | 36 | Linux_SLCNAND_UBI_开发指南 | PDF
 |  | 37 | Linux_AMP_开发指南 | PDF
 | Linux模块开发指南-bsp仓库独立 | 1 | Linux_BSP独立仓库_开发指南 | pdf
 | Tina系统基础组件 开发指南(CN) | 1 | Tina_Linux_配置_开发指南 | PDF
 |  | 2 | Tina_Linux_OTA_开发指南 | PDF
 |  | 3 | Tina_Linux_功耗管理_开发指南 | PDF
 |  | 4 | Tina_Linux_音频_开发指南 | PDF
 |  | 5 | Tina_Linux_安全_开发指南 | PDF
 |  | 6 | Tina_Linux_多媒体解码_开发指南 | PDF
 |  | 7 | Tina_Linux_多媒体编码_开发指南 | PDF
 |  | 8 | Tina_Linux_存储_开发指南 | PDF
 |  | 9 | Tina_Linux_系统裁剪_开发指南 | PDF
 |  | 10 | Tina Linux_Camera_开发指南 | PDF
 |  | 11 | Tina_Linux_Key_快速配置_使能指南 | PDF
 |  | 12 | Tina_Linux_电源管理_开发指南 | PDF
 |  | 13 | Tina_Linux_syslog使用指南 | PDF
 |  | 14 | Tina_Linux_USB开发指南 | PDF
 |  | 15 | Tina_Linux_各平台多媒体格式_支持列表 | PDF
 |  | 16 | Tina_Linux_量产测试使用指南 | PDF
 |  | 17 | Tina_Linux_温度控制_使用指南 | PDF
 |  | 18 | Tina_Linux_NPU模型部署_开发指南 | PDF
 |  | 19 | Tina_Linux_NPU部署工具安装指导 | PDF
 |  | 20 | Tina_Linux_NPU模型运行工具vpm_run_使用指南 | PDF
 |  | 21 | Tina_Linux_NPU开发系统介绍 | PDF
 |  | 22 | Tina_Linux_NPU应用软件架构设计 | PDF
 |  | 23 | Tina_Linux_NPU_量化调试_参考指南 | PDF
 |  | 24 | Tina_Linux_NPU_VivanteIDE工具_使用指南 | PDF
 |  | 25 | Tina_Linux_NPU_NBG分析工具nbinfo_使用指南 | PDF
 |  | 26 | Tina_Linux_调频系统_使用指南 | PDF
 |  | 27 | TinaLinux_打包流程说明文档 | PDF
 |  | 28 | Tina_Linux_异构通信框架_开发指南 | PDF
 |  | 29 | T527平台无线规格支持列表 | PDF
 |  | 30 | Tina_Linux_Wi-Fi_模组移植指南 | PDF
 |  | 31 | Tina_Linux_Wi-Fi_软件开发指南 | PDF
 |  | 32 | Tina_Linux_Wi-Fi_常见问题与调试指南 | PDF
 |  | 33 | Tina_Linux_Wi-Fi_抓包使用指南 | PDF
 |  | 34 | Tina_Linux_蓝牙_软件开发指南 | PDF
 |  | 35 | Tina_Linux_蓝牙_模组移植指南 | PDF
 |  | 36 | Tina_Linux_蓝牙_常见问题与调试指南 | PDF
 |  | 37 | Tina_Linux_Wi-Fi_BT_射频测试指南 | PDF
Tool 工具类文档 | 烧写工具 使用指南 | 1 | PhoenixSuit_使用指南 | PDF
 |  | 2 | PhoenixUSBPro_使用指南 | PDF
 |  | 3 | PhoenixUSBPro二次开发_使用指南 | PDF
 |  | 4 | DragonSN配置工具_使用指南 | PDF
 |  | 5 | TigerDOS远程调试工具_调试指南 | PDF
 |  | 6 | linux系统烧录工具_使用指南 | PDF
 |  | 7 | Mac电脑烧录工具_使用指南 | PDF
 |  | 8 | 全志量产工具中心_使用指南 | PDF
 | 调试工具 使用指南 | 1 | TigerISP调试工具_使用指南 | PDF、AVI
 |  | 2 | Crashdump调试工具_使用指南 | PDF、AVI
 |  | 3 | TigerAACT_使用指南 | PDF
 |  | 4 | TigerDebug调试工具_使用指南 | PDF
 |  | 5 | DragonFace_使用指南 | PDF
 |  | 6 | DragonSN_使用指南 | PDF
 |  | 7 | DragonHD_使用指南 | PDF
 |  | 8 | DragonMAT_使用指南 | PDF
 |  | 9 | DragonMAT二次开发_使用指南 | PDF
 |  | 10 | TigerPQ调试工具_使用指南 | PDF
 |  | 11 | TigerDump_使用指南 | PDF
Product 量产指导文档 | 产线指南 | 1 | 产线生产流程指南 | PDF
 |  | 2 | 产线批量烧写工具部署培训指南 | PDF、AVI
 |  | 3 | 产线量产稳定性检查checklist | PDF
 |  | 4 | 产线软硬件问题快速排查指南 | PDF
 |  | 5 | 全志平台生产指南之ESD基础及其防护 | PDF
 | 排查指南 | 1 | eMMC硬件_排查指南 | PDF
 |  | 2 | Linux_eMMC物料_调试指南 | PDF
 |  | 3 | Tina_eMMC物料_调试指南 | PDF
 |  | 4 | eMMC量产问题_排查指南 | PDF
 |  | 5 | NAND量产问题_排查指南 | PDF
 |  | 6 | IO类量产问题_排查指南 | PDF
 |  | 7 | 安全类量产问题_排查指南 | PDF
 |  | 8 | 启动烧写类量产问题_排查指南 | PDF
 |  | 9 | 量产系统稳定性问题_排查指南 | PDF
 |  | 10 | 量产问题信息收集_参考模板 | PDF
 |  | 11 | 接口类量产问题_排查指南 | PDF
