openedv/development_board_ATK-DLT527B/(list of files, cad)

Other CAD files:
03_core_board/03_mechanical_structure/ATK-CLT527B V1.0 BOTTOM.DXF
03_core_board/03_mechanical_structure/ATK-CLT527B V1.0 TOP.DXF
