openedv/development_board_ATK-DLT527B/10_user_manual/README.txt

The Chinese documentation for the ATK-DLT527B development board has been updated to an online version, and PDF documents are no longer provided.

Online Documentation Link: https://alientek.yuque.com/iad599/itogty?#
