openedv/development_board_ATK-DLT527B/03_core_board/04_product_baseboard_design_reference_materials/Product Baseboard Hardware Design Reference Manual.txt

Please refer to the online documents: 
Online Documentation for Development Board -> Hardware Design Reference：
https://alientek.yuque.com/iad599/itogty?# 《ATK-DLT527B开发板文档资料》
