openedv/development_board_ATK-DLT527B/03_core_board/04_product_baseboard_design_reference_materials/Voltage Test Point Reference for ATK-CLT527B Core Board.pdf

# ATK-CLT527B 核心板电压测试点参考

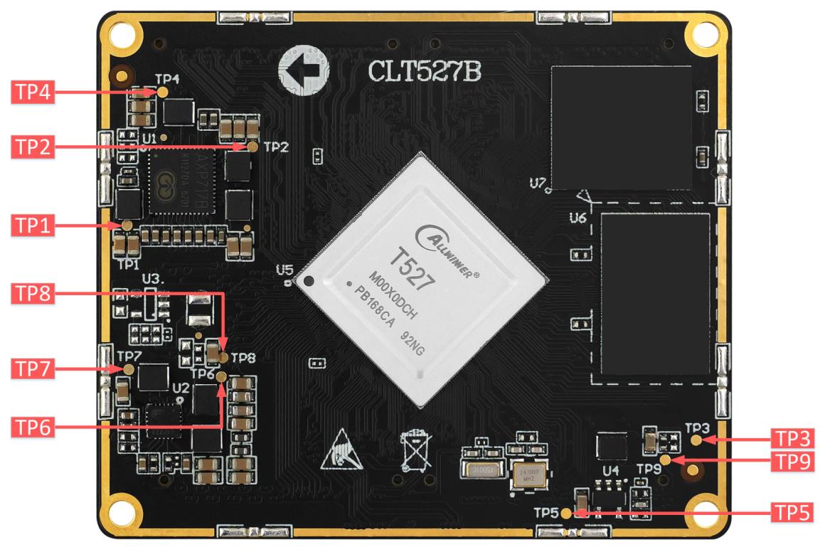
[picture p18: figure]

测试点 | 电源名称 | 说明 | 电压值
TP1 | VDD-CPUL | CPU 小核供电 | 0.9~1.1V (跟随 CPU 频率动态调 节，频率越大、电压越 高)
TP2 | VDD-SYS | 系统供电 | 0.92V
| VDD-GPU | GPU 供电
| VDD-VE | VE 模块供电
| VDD-DE | DE 模块供电
| VDD09-USB | 0.9V USB 数字电源
| VDD09-PCIE | PCIe2.1 的 0.9V 电源
| VDD09-EDP | 0.9V EDP 数字电源
| VDD09-HDMI | 0.9V HDMI 数字电源
TP3 | VCC-DRAM | DRAM IO 电源 | 1.16V
TP4 | VCC-PD | PD 组 IO 电源 | 3.3V
| VCC-PE | PE 组 IO 电源
| VCC-PI | PI 组 IO 电源
| VCC-PJ | PJ 组 IO 电源
| VCC-PK | PK 组 IO 电源
| VCC33-USB-2 | USB2.0 PHY 的 3.3V 电源

TP5 | PS | PMIC 各路 DCDC 的输入电源 | 3.98V
TP6 | VDD-CPUB | CPU 大核供电 | 0.9~1.15V (跟随 CPU 频率动态调 节，频率越大、电压越 高)
TP7 | VDD-DNR | DSP、NPU、RISC-V 核供电 | 1.0V
TP8 | VDD-VE | VE 模块供电 | 0.92V
TP9 | VCC-DRAML | LPDDR4X 颗粒所需的 DCDC 供电 | 范围：0.57~0.65V 典型值：0.6V
