openedv/development_board_ATK-DLT527B/03_core_board/04_product_baseboard_design_reference_materials/ATK-CLT527B Core Board Voltage Test Points.pdf

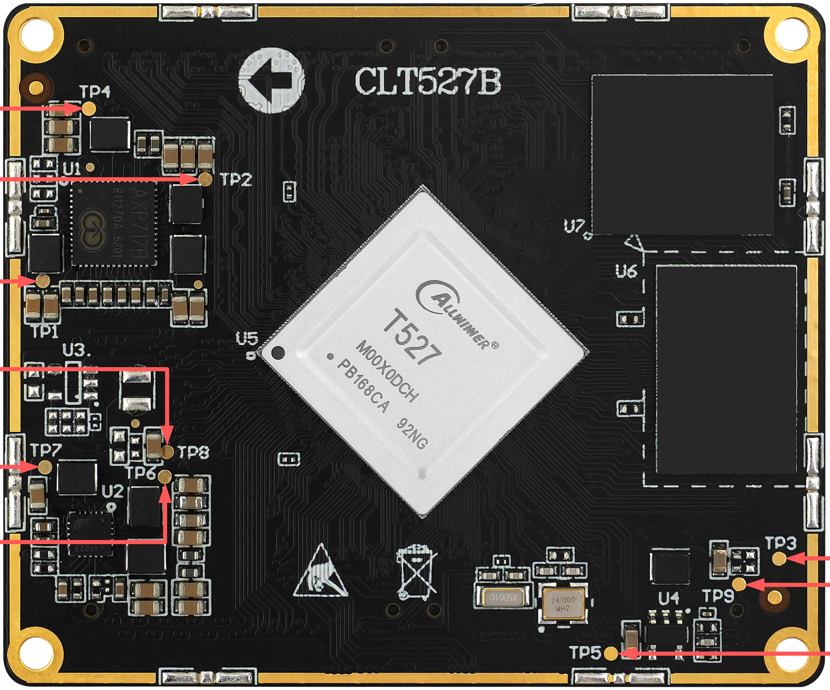
[picture p19: figure]
MIPI CSI

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
