openedv/development_board_ATK-DLT527B/03_core_board/03_mechanical_structure/ATK-CLT527B V1.0 Mechanical dimension diagram.pdf

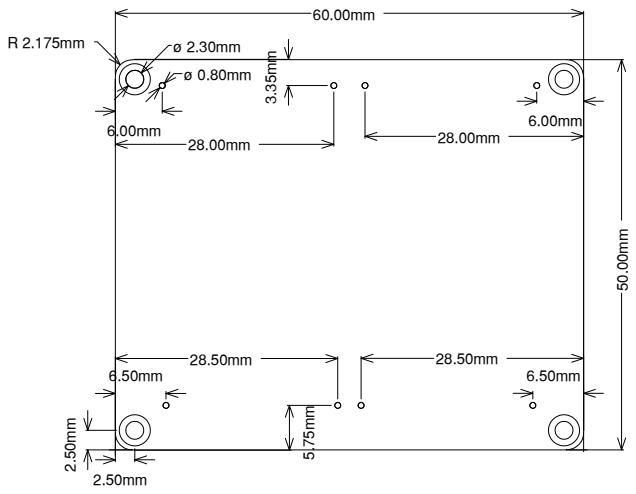
[picture p44: page 1]
