openedv/development_board_ATK-DLT527B/07_hardwares/01_development_board_specifications/Front-side Resource Distribution Diagram of ATK-DLT527B Development Board.pdf

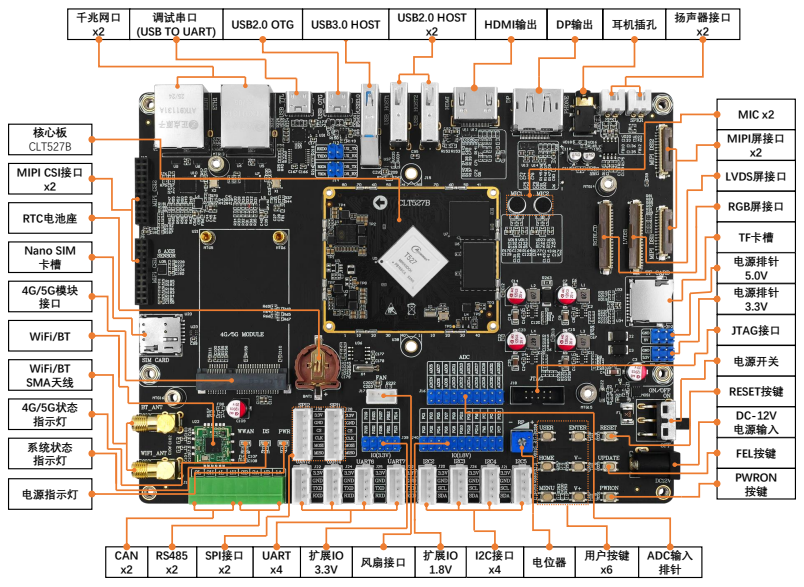
[picture p43: page 1]
千兆网口 x2; 调试串口; (USB TO UART); USB2.0 OTG; USB3.0 HOST; USB2.0 HOST; HDMI输出; DP输出; 耳机插孔; 扬声器接口; MIC x2; MIPI屏接口 x2; LVDS屏接口; RGB屏接口; TF卡槽; 电源排针 5.0V 电源排针 3.3V; JTAG接口; 电源开关; RESET按键; DC-12V 电源输入; FEL按键; PWRON 按键; ADC输入 排针; 用户按键 x6; 电位器 I2C接口 x4; 扩展IO 1.8V; 风扇接口 扩展IO 3.3V; UART x4; SPI接口 x2; CAN x2; 核心板 CLT527B; MIPI CSI接口 x2; RTC电池座; Nano SIM 卡槽; 4G/5G模块 接口; WiFi/BT; WiFi/BT SMA天线; 4G/5G状态 指示灯; 系统状态 指示灯; 电源指示灯
